actaeon7777/multifloor-amr/src/amr_system/amr_stack/maps/G_5_floor/MAP_SOURCE.md

# 5층 지도 (실측, 4층 좌표계 정렬)

- `5_floor_1006_slam.*`: 2026-10-06 5층 SLAM 원본 (받은 그대로, 자체 좌표계)
- `5_floor_1006.*`: 원본을 4층 지도 좌표계로 옮긴 실차용 지도 (`floors.yaml`의 `map`)
  - 변환(원본 → 4층): yaw 182.844°, t (46.294, 0.562) m. 셀 격자는 4층과 같고 범위만 넓다.
  - 원본 벽의 59%가 4층 벽 0.15 m 이내, 엘리베이터 문 위치 차이 약 4.5 cm.
  - 층을 바꿀 때 자세 값을 그대로 쓰므로(엘리베이터 미션 RELOCALIZE) 모든 층이 같은 좌표계여야 한다.
  - 다시 만들기: `scripts/align_floor_map.py 5_floor_1006_slam.yaml ../G_4_floor/4_floor_0522.yaml 5_floor_1006.yaml`
- `5_floor_tmp_from_4F(영역지정).png`: 시뮬레이션 전용. 내용은 아직 4층 영역지정의 복사본이며 새 지도 격자에 맞춰
  바깥만 넓혔다. 시뮬레이션 5층 장면(`sim_map`, `sim_layer`)도 아직 4층 복사본이다.
- 호실 좌표(`floors.yaml` rooms)는 4층 값을 옮긴 것이다. 새 지도에서 모두 복도 빈 공간이지만 실제 문 위치는 현장 확인 전이다.
