actaeon7777/multifloor-amr/src/amr_system/amr_web_ui/README.md

# AMR Web UI

컨셉 A Clarity 운영 웹과 로컬 HTTP / ROS 브리지다.

- [차량 스택과 웹 실행](../../../docs/README.md#1-amr-실행)
- [웹 접속](../../../docs/README.md#2-웹-접속)
- [주행 조작](../../../docs/README.md#3-주행-조작)
