actaeon7777/multifloor-amr/PORTING_JAZZY.md

# Jazzy 포팅 기록

차량 운용은 [실운용 실행법](docs/README.md)을 사용한다.
기존 포팅 기록은 [이력](docs/archive/20261007/root/PORTING_JAZZY.md)에 보관한다.
