actaeon7777/multifloor-amr/실행법.md

# AMR 실행법

차량 실행부터 종료까지는 **[실운용 실행법](docs/README.md)**을 사용한다.
