actaeon7777/multifloor-amr/docs/KIOSK.md

# 배송 키오스크

Jetson의 가로 터치 화면에서 사용하는 배송 화면이다. 웹 주소는
`http://127.0.0.1:8080/kiosk`이며, 1920×1280 화면을 Chromium 배율 1.5
(CSS 1280×853)로 표시한다. 서버가 준비되어 있어야 한다.

## 시작·종료

로그인한 데스크톱의 터미널에서 `scripts/kiosk/launch.sh`를 실행한다.
`AMR_WEB_PORT=8080`으로 포트를 지정할 수 있다. 실행기는 웹 응답을 최대 약 2분 기다린 뒤
별도 Chromium 프로필 `~/snap/chromium/common/amr-kiosk`로 연다.
`curl`, `flock`, `gsettings`, `xwininfo`·`xprop`(x11-utils), Python 3, libX11, Snap Chromium이 필요하다.
Chromium 자체의 `--kiosk` 전체화면은 약 0.1초 뒤 일반 창으로 풀리므로(2026-10-28 측정), 실행기가
브라우저가 떠 있는 동안 창 상태(`_NET_WM_STATE_FULLSCREEN`)를 처음 30초는 0.5초, 이후 2초 간격으로 확인해 풀리면 다시 요청한다.

종료는 관리 모드의 **키오스크 닫기**(화면만 닫고 로봇은 계속 켜져 있음), 키보드 `Alt+F4`, 또는 실행한 터미널에서 `Ctrl+C`.
**키오스크 닫기**는 서버가 실행기 PID 파일(`$XDG_RUNTIME_DIR/amr-kiosk-<UID>.pid`)의 `launch.sh`에 SIGTERM을 보내는 방식이라
실행기가 없으면 `--class=amr-kiosk` Chromium을 직접 닫는다. 로봇 PC 자신(loopback)에서 보낸 요청만 받고, PIN이 있으면 관리 모드 토큰이 필요하다.
바탕화면 "AMR 시작" 아이콘은 키오스크를 사용자 서비스 `amr-kiosk`(systemd-run)로 띄운다. 바탕화면 아이콘(DING)에서 바로 실행한 프로세스는
AppArmor 라벨 `desktop-icons-ng`를 물려받는데 Chromium snap이 이 라벨이 보내는 종료 신호를 거부해서, 실행기가 브라우저를 닫지 못하고 멈췄기 때문이다(2026-10-28 확인).
"AMR 종료"는 `systemctl --user stop amr-kiosk`로 닫는다.
실행기를 새로 띄울 때 실행기 없이 남은 키오스크 Chromium이 있으면 먼저 닫는다(남아 있으면 새 실행이 기존 창에 주소만 넘기고 끝나 전체화면 감시·키오스크 닫기가 동작하지 않는다).
실행 중 화면 꺼짐·잠금을 해제하고 정상 종료·종료 신호 처리 때 이전 값을 복원한다.
강제 종료(SIGKILL)·전원 차단은 복원을 실행할 수 없으므로 GNOME 설정을 확인한다.
브라우저 종료는 배송 취소가 아니다. 배송 취소에는 화면의 **정지**를 누른다.

자동 시작은 필요할 때 사용자가 설치한다. 이 작업에서는 설치하지 않는다.

```bash
mkdir -p ~/.config/autostart
cp /home/acus03/amr_ws/scripts/kiosk/amr-kiosk.desktop ~/.config/autostart/
```

다른 checkout에서는 desktop 파일의 `Exec` 절대 경로를 바꾼다.
자동 시작 해제는 `~/.config/autostart/amr-kiosk.desktop`을 삭제한다.

## 화면·배송

- **대기**: 층과 호실 선택 → 배송지 확인 → 출발. 현재 층은 `현재 층`, 비활성 층은 `운행 안 함`으로 표시한다.
- **배송 중**: 출발 버튼을 누르면 즉시 표시하고 약 3초 후 목표를 한 번 전송한다. 대기 중에는 진행률 0, 예상 도착 미표시이며 카운트다운은 없다. 이때 정지는 전송 없이 대기만 취소한다. 전송 후 정지는 진행 중인 배송을 보낸 곳과 관계없이 취소한다(브라우저가 다시 떠도 정지할 수 있게).
- **엘리베이터**: 승강장 이동·호출·탑승·층 이동·하차·호실 도착의 6단계와 경과 시간을 표시한다.
- **도착 / 배송 실패 / 배송 취소**: 이 키오스크가 보낸 호실 배송의 결과. `수령 확인` 또는 `확인`을 누르고 서버가 승인할 때까지 유지한다. 같은 탭 새로고침에도 배송 요청 ID를 기억한다.
- **준비 중**: 위치·층·주행 준비 확인 전에는 호실 선택이 잠긴다.
- **수동 조작 / 비상 정지**: 배송 화면보다 우선 표시한다.
- **연결 대기**: 조회 실패 또는 약 3초 이상 된 상태에서는 마지막 화면 위에 표시하고 새 명령을 막는다. 미전송 출발 대기는 취소하며 자동 재출발하지 않는다.

진행률은 유효한 거리 피드백을 받은 첫 3초의 최대 남은 거리 대비 감소량이며 뒤로 줄지 않는다. 초기 0.05 m 이하 값은 무시한다. 예상 도착은 최근 약 10초의
거리 감소 속도로 추정하며 데이터가 부족하면 0.3 m/s를 사용한다. 배터리는 신선한 BMS 잔량을 우선 사용하고, 없으면 기존 대시보드의 전압 기준으로
추정한다. 유효한 전원 데이터가 없으면 숨긴다. 지도·호실 좌표와 다른 층의 지도 버전은 `/api/floors`에서 가져온다. 현재 층 명령에는 `/api/kiosk/state`의 라이브 지도 버전을 사용한다.

## 관리 모드

상단 ⚙를 누른다. PIN은 웹 UI를 띄우는 터미널에서 `export AMR_KIOSK_PIN=<숫자>`로 설정한다.
`kiosk_pin:=` launch 인자도 받지만 명령줄(`ps`)에 PIN이 그대로 보이므로 쓰지 않는다. PIN이 있으면 숫자 키패드로 잠금을 해제한다. 미설정 시 바로 열리고
`PIN 잠금 해제됨 (시험 운영)`을 표시한다.

현재 층 지도에서 위치를 누르고 방향으로 끈 뒤 `적용`을 누른다. `마지막 위치로 시작`에는
현재 층 이름·저장 시각이 표시되며 해당 `적용`으로 현재 지도의 저장 위치를 전송한다. `현재 층 변경`은 실제 층 정보가 다를 때 사용한다.
주행·요청 처리 중에는 위치·층 변경 버튼이 잠긴다.

토큰은 메모리에만 보관한다. `관리 모드 종료`, 5분 입력 없음, 토큰 유효기간 만료 또는
관리 요청의 403 오류에서 관리 모드를 종료한다. 서버 오류는 화면에 그대로 표시한다.

## 원격 정지(관리자 정지)

중앙 관제의 **정지**는 로봇 내부에 관리자 정지를 설정하고 진행 중 목표를 취소한다.
연결이 끊겨도 유지되며, **해제**는 정지만 풀고 이전 배송을 재개하지 않는다. 조이스틱 LB 수동 조작은 계속 가능하다.
키오스크는 `관리자 정지 중`을 표시하며 관리 모드에 들어갈 수 있다. 엘리베이터 구간에서 누른 정지는
하차가 끝날 때까지 보류되고 층간 이동 화면에 `하차 후 정지 예정`이 뜬다([실차 레퍼런스](REAL_VEHICLE.md#원격-정지관리자-정지)).

**복귀**는 정지를 해제하고 기존 목표 종료·주행 준비를 기다린 뒤 `floors.yaml`의
`home`(초기값 4F 401호)으로 이동한다. 30초 안에 출발할 수 없으면 실패 사유를 표시한다.
복귀 화면은 `관리자 호출로 복귀 중`이며 배송 정지 버튼·수령 확인·배송 알림을 표시하지 않는다.
`/api/state`와 `/api/kiosk/state`의 `hold`, 서버에서 계산한 `task`, `goal.origin`으로 상태를 구분한다.
`/api/stop`, `/api/resume`, `/api/return_home`은 운영자용이며 키오스크 헤더로 요청하면 403이다.

## 야간 순찰

중앙 관제 또는 로봇 터치 패널의 **관리 모드 → 야간 순찰**에서 등록 경로를 선택해 **순찰 시작**을 요청한다. 키오스크는 수신 후 3초 미만인
`patrol.active=true` 상태에서 **야간 순찰 중** 경고 화면과 `경로 · 순서/전체 · 이동/관측/복귀`를
표시하고 배송지 선택을 막는다. 비상 정지·수동 조작·관리자 정지가 순찰 화면보다 우선한다.
상단 관리 모드에는 계속 들어갈 수 있다. 3초 이상 오래된 순찰 상태는 화면을 잠그지 않으며,
종료(`DONE`)·중단(`ABORTED`) 후 `active=false`이면 기존 배송·준비 상태에 따른 화면으로 돌아간다.

로컬 `/api/patrol/start`는 `{request_id, route}`, `/api/patrol/stop`은 `{request_id}`를 받는
운영자 및 키오스크 관리 모드용 POST다. PIN이 설정되어 있으면 키오스크 요청에는 유효한 관리자 토큰이 필요하며,
없으면 403 `관리 모드 잠금을 먼저 해제하세요.`로 거절된다. PIN 미설정 시 토큰 없이 허용한다. 시작은 등록된 경로와
주행 준비가 필요하며 진행 중 목표·층간 미션·관리자 정지 시 409다. 순찰 중 새 배송은
`야간 순찰 중에는 배송을 받을 수 없습니다. 중앙 관제에서 순찰을 정지하세요.`로 거절된다.
순찰 정지는 신선한 활성 순찰이 있을 때만 받는다.

관리 모드의 야간 순찰 블록에는 경로 선택·진행 상태·**순찰 시작**·**순찰 정지**가 표시된다.
경로 목록이 바뀌어도 선택한 경로가 남아 있으면 선택을 유지한다. 시작 요청이 접수되면 관리 모드를
종료하고 순찰 상태 수신 후 **야간 순찰 중** 화면을 표시한다. 정지하려면 상단 ⚙로 관리 모드에
다시 들어간다. 주행 중에도 순찰 정지 버튼을 사용할 수 있으며, 서버가 거절하거나 응답이 지연되면
오류 문구를 화면에 표시한다. 오프라인·요청 처리 중에는 버튼이 잠기고, 관리자 정지·진행 중 목표·
관리 작업 차단 상태에서는 순찰 시작을 할 수 없다.

명령은 executor에서 `/patrol/command`에 발행하고 `/patrol/status`의 같은 요청 ID 응답을
기다린다. HTTP 202 이후 상태의 `notice`가 `SUCCEEDED` 또는 `FAILED`로 갱신되며,
3초 안에 응답이 없으면 `순찰 노드가 응답하지 않습니다.`가 표시된다. 자동 재전송은 없다.
preview는 ROS 송신 없이 순찰 상태를 바꾸고 `PREVIEW`로 완료한다.
기존 관리자 **정지**·**복귀**도 순찰 정지를 먼저 발행한 뒤 기존 동작을 수행한다.
