actaeon7777/multifloor-amr/reports/profile/20261025_144835_before_opt.csv

time | label | pid | cpu_percent | rss_mb | threads
0.1 | _total | 0 | 69.4 |  | 3.70
0.1 | snapd | 1083 | 0.0 | 40 | 13
0.1 | gnome-shell | 4572 | 0.0 | 470 | 19
0.1 | gnome-shell | 4611 | 0.0 | 16 | 7
0.1 | gnome-shell | 4633 | 0.0 | 25 | 10
0.1 | gnome-software | 4717 | 0.0 | 257 | 8
0.1 | gnome-shell | 5028 | 0.0 | 25 | 10
0.1 | gnome-shell | 5194 | 0.0 | 60 | 13
0.1 | update-manager | 7391 | 0.0 | 230 | 7
0.1 | chrome | 23459 | 0.0 | 240 | 10
0.1 | ros2_launch | 23638 | 0.0 | 41 | 3
0.1 | sllidar_node | 23707 | 0.0 | 40 | 17
0.1 | scan_body_filter | 23708 | 0.0 | 85 | 15
0.1 | robot_state_publisher | 23709 | 0.0 | 43 | 15
0.1 | orbbec_camera_node | 23710 | 0.0 | 136 | 46
0.1 | depth_persistence_filter | 23711 | 0.0 | 44 | 16
0.1 | joy_node | 23712 | 0.0 | 45 | 16
0.1 | joy_teleop | 23713 | 0.0 | 83 | 15
0.1 | control_mux | 23714 | 0.0 | 84 | 16
0.1 | time_health | 23715 | 0.0 | 86 | 16
0.1 | can_telemetry | 23719 | 0.0 | 90 | 16
0.1 | ekf_node | 23723 | 0.0 | 49 | 16
0.1 | cmd_vel_to_can | 23724 | 0.0 | 87 | 15
0.1 | map_server | 23727 | 0.0 | 53 | 15
0.1 | amcl | 23728 | 0.0 | 62 | 17
0.1 | lifecycle_manager | 23729 | 0.0 | 46 | 17
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
