actaeon7777/multifloor-amr/reports/profile/20261025_201213_after_opt.csv

time | label | pid | cpu_percent | rss_mb | threads
0.1 | _total | 0 | 64.7 |  | 5.24
0.1 | snapd | 1083 | 0.0 | 28 | 13
0.1 | gnome-shell | 4572 | 0.0 | 333 | 19
0.1 | gnome-shell | 4611 | 0.0 | 3 | 7
0.1 | gnome-shell | 4633 | 0.0 | 10 | 10
0.1 | gnome-software | 4717 | 0.0 | 47 | 8
0.1 | gnome-shell | 5028 | 0.0 | 11 | 10
0.1 | gnome-shell | 5194 | 0.0 | 22 | 13
0.1 | update-manager | 7391 | 0.0 | 93 | 7
0.1 | chrome | 86484 | 0.0 | 282 | 17
0.1 | ros2_launch | 86628 | 0.0 | 42 | 3
0.1 | sllidar_node | 86679 | 0.0 | 37 | 17
0.1 | scan_body_filter | 86680 | 0.0 | 83 | 15
0.1 | robot_state_publisher | 86681 | 0.0 | 40 | 15
0.1 | orbbec_camera_node | 86682 | 0.0 | 135 | 46
0.1 | depth_persistence_filter | 86683 | 0.0 | 43 | 16
0.1 | joy_node | 86684 | 0.0 | 42 | 16
0.1 | joy_teleop | 86686 | 0.0 | 80 | 15
0.1 | control_mux | 86690 | 0.0 | 81 | 16
0.1 | time_health | 86693 | 0.0 | 84 | 16
0.1 | can_telemetry | 86695 | 0.0 | 87 | 16
0.1 | ekf_node | 86699 | 0.0 | 46 | 16
0.1 | cmd_vel_to_can | 86700 | 0.0 | 84 | 15
0.1 | map_server | 86704 | 0.0 | 50 | 15
0.1 | amcl | 86711 | 0.0 | 58 | 17
0.1 | lifecycle_manager | 86716 | 0.0 | 43 | 16
0.1 | planner_server | 86721 | 0.0 | 44 | 15
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
