actaeon7777/multifloor-amr/reports/profile/20261027_153326_after_opt2.csv

time | label | pid | ppid | exe | cpu_percent | rss_mb | threads
0.1 | _total | 0 | 0 |  | 62.1 |  | 4.59
1.3 | _total | 0 | 0 |  | 49.5 |  | 4.30
1.3 | snapd | 1086 | 1 | snapd | 0.0 | 31 | 13
1.3 | gnome-shell | 6736 | 6434 | gnome-shell | 2.6 | 394 | 19
1.3 | gnome-shell | 6778 | 6434 | gnome-shell-calendar-server | 0.0 | 7 | 7
1.3 | gnome-shell | 6816 | 6434 | gjs | 0.0 | 17 | 10
1.3 | gnome-shell | 7126 | 6434 | gjs | 0.0 | 18 | 10
1.3 | gnome-shell | 7307 | 6736 | gjs | 0.0 | 32 | 13
1.3 | chrome | 63673 | 37877 | claude | 0.0 | 287 | 11
1.3 | ros2_launch | 77126 | 39867 | ros2 | 0.0 | 41 | 3
1.3 | sllidar_node | 77183 | 77126 | sllidar_node | 6.1 | 39 | 17
1.3 | scan_body_filter | 77184 | 77126 | scan_body_filter | 1.7 | 84 | 15
1.3 | robot_state_publisher | 77185 | 77126 | robot_state_publisher | 0.9 | 42 | 15
1.3 | orbbec_camera_node | 77186 | 77126 | orbbec_camera_node | 8.7 | 124 | 46
1.3 | depth_persistence_filter | 77187 | 77126 | depth_persistence_filter | 1.7 | 44 | 16
1.3 | joy_node | 77188 | 77126 | joy_node | 2.6 | 44 | 16
1.3 | joy_teleop | 77189 | 77126 | joy_teleop | 1.7 | 82 | 15
1.3 | control_mux | 77190 | 77126 | control_mux | 6.1 | 82 | 16
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
