actaeon7777/multifloor-amr/docs/archive/20261007/root/실행법.md

> **이력 문서** · 2026-10-07 정리 시점의 이전 안내입니다. 현재 실행은 [최신 운영 문서](../../../README.md), 검증은 [검증 문서](../../../VALIDATION.md)를 사용합니다.

# 2026-10-06 PC 작업물 직접 이식 이후 실행

현재 `/home/acus03/amr_ws`에 새 주행·위치추정·웹 기능을 반영했다. 기존 `amr` 별칭을 유지한다.
**현재 실행 순서는 [중앙 관제 실행 안내](../docs/AMR_REMOTE_REAL_DRIVE_TEST.md)를 따른다.**

- 터미널 1: `./scripts/experiment.sh real can_dry_run:=true`로 먼저 확인한다.
- 터미널 2: `amr` 후 `ros2 launch amr_web_ui web_ui.launch.py use_sim_time:=false host:=127.0.0.1 port:=8080`.
- 터미널 3: 기존 `remote_client`로 중앙 서버 `100.88.249.77:8081`에 연결한다.
- 초기 위치 검증 후 Nav2가 활성화된다. 아래 과거 안내의 별도 stack/localization/navigation을 중복 실행하지 않는다.
- 실송신은 dry-run 종료 후 `./scripts/experiment.sh real`로 시작한다. 실제 주행은 현장 확인 뒤 수행한다.
- 다른 노트북은 기존 Tailscale 중앙 웹 주소를 사용한다. 새 자동 위치 찾기를 쓰려면 중앙 서버 업데이트도 필요하다.

이하 내용은 과거 실행 기록 및 개별 기능 참고다. 최신 통합 실행은 위 링크가 기준이다.

---

# AMR 실행법

## 2026-10-04 PC 전달본 적용

`amr_jetson_orin_20261004.tar.gz`의 소스를 이 Jetson 작업공간에 적용했습니다.
기존 `amr` / `stack` 명령과 아래의 터미널별 실행 방법은 그대로 사용할 수 있습니다.
새 터미널에서 `amr`을 실행해 새 빌드 환경을 불러오세요.

차량·센서·EKF + 저장 지도·AMCL + 내비게이션을 한 번에 실행할 수도 있습니다.
이 명령은 아래의 터미널 1~3을 대신하므로 둘을 동시에 실행하지 않습니다.

```bash
cd /home/acus03/amr_ws
# 먼저 CAN 송신 없이 센서 및 전체 스택 확인
./scripts/experiment.sh real can_dry_run:=true
# 위 명령을 Ctrl+C로 종료한 뒤, 실차 운용 준비가 끝나면 실제 CAN 송신
./scripts/experiment.sh real
```

웹 UI는 별도 터미널에서 `amr` 후 `ros2 launch amr_web_ui web_ui.launch.py`로 실행합니다.
실물은 ROS 도메인 7, `use_sim_time=false`이며 Isaac Sim 설치는 필요하지 않습니다.
원본 README는 PC 시뮬레이션 안내이므로 Jetson 운용에는 이 문서를 사용합니다.
적용 전 소스와 빌드 결과는 `backups/before_jetson_port_20261004/`에 보관했습니다.
이번 이식 결과와 검증 로그는 `diagnostics/jetson_port_20261004/`에 있습니다.

# rosbag 수집 명령어
amr
AMR_EXPERIMENT_MODE=real ./scripts/record_trial.sh

```bash
# 터미널 1: 실제 차량·센서·EKF (기존 stack)
amr
stack

# 터미널 2: 기존 지도·AMCL
amr
ros2 launch amr_stack localization.launch.py

# 터미널 3: 목표점 주행·RViz
amr
ros2 launch amr_stack navigation.launch.py use_rviz:=true

# 터미널 3: 웹 서버 제어 방식
amr
ros2 launch amr_stack navigation.launch.py

# 터미널 4: 웹 서버 실행
amr
ros2 launch amr_web_ui web_ui.launch.py
```

작업공간: `/home/acus03/amr_ws` · ROS 2 Jazzy

각 터미널에서 먼저 `amr`을 실행합니다. `stack`은 `ros2 launch amr_stack bringup.launch.py`의 별칭입니다.
이미 실행 중인 `stack`은 유지하고 필요한 기능만 다른 터미널에 추가합니다.

| 하고 싶은 작업 | 사용할 구성 | 문서 위치 |
|---|---|---|
| 저장된 지도에서 목표점으로 주행 | stack + AMCL + navigation | 2번 |
| 웹 지도에서 터치로 목표점 지정 | 기존 주행 구성 + amr_web_ui | 2번의 웹 UI |
| 조이스틱 수동 주행 | stack | 3번 |
| 새 지도 만들기·저장 | stack + SLAM Toolbox | 4번 |
| 저장 지도에서 위치추정만 실행 | stack + AMCL | 5번 |
| LiDAR·차량 모델 표시 | lidar 런치 | 6번 |
| CAN 송신 없이 센서나 명령 확인 | stack 실행 옵션 변경 | 7번 |
| 1 m 직진·90° 회전·반복 회전 | stack + 해당 시험 스크립트 | 8번 |
| 위치·속도·모드·토픽 조회 | ROS 조회 명령 | 9번 |
| 코드 변경 후 빌드 | colcon | 10번 |
| 하드웨어 없이 자동 테스트 | 격리된 ROS 도메인의 테스트 | 12번 |

## 1. 공통 준비

### 터미널 환경

```bash
amr
```

`amr` 별칭이 없는 터미널에서는 다음을 실행합니다.

```bash
cd /home/acus03/amr_ws
source /opt/ros/jazzy/setup.bash
source scripts/env.sh
```

### 실제 CAN을 사용할 때

등록한 `can0.service`가 부팅 시 CAN 인터페이스를 설정합니다. 현재 상태를 조회합니다.

```bash
ip -details link show can0
systemctl status can0.service
```

설정이 필요하면 차량을 정지시키고 기존 `stack`을 종료한 상태에서 **500 kbit/s, 일반 CAN**으로 준비합니다.
이미 올바르게 설정되어 있다면 아래 명령을 반복할 필요는 없습니다.

```bash
sudo systemctl restart can0.service
```

### 함께 실행하는 프로그램

- `stack`은 조이스틱·mux·CAN 송수신·LiDAR·차량 TF·EKF를 포함합니다.
- `localization.launch.py`는 저장 지도와 AMCL을 실행합니다.
- `navigation.launch.py`는 Smac 2D·DWB·방향 정렬 보조·복구·목표 관리를 실행합니다.
- SLAM과 AMCL은 각각 `map → odom`을 발행하므로 **둘 중 하나만 실행**합니다.
- `stack`과 `lidar.launch.py`를 동시에 실행하면 LiDAR·차량 TF가 중복됩니다.
- navigation과 8번의 주행 시험 스크립트는 모두 `/cmd_vel_auto`를 사용하므로 **한 가지만 실행**합니다.

## 2. 저장 지도에서 목표점 주행 — 평소 사용하는 실행

### 터미널 1: 차량·센서·EKF

```bash
amr
stack
```

기본값은 실제 CAN 송신입니다. 이미 실행 중이면 그대로 둡니다.

### 터미널 2: 저장 지도·AMCL

```bash
amr
ros2 launch amr_stack localization.launch.py
```

기본 지도는 `/home/acus03/amr_ws/maps/G_4_floor/4_floor_0522.yaml`입니다.
다른 지도를 사용할 때는 위 명령 대신 지도 경로를 지정합니다.

```bash
amr
ros2 launch amr_stack localization.launch.py \
  map:=/home/acus03/amr_ws/maps/my_map/map.yaml
```

### 터미널 3: 내비게이션·RViz

```bash
amr
ros2 launch amr_stack navigation.launch.py use_rviz:=true
```

RViz 없이 내비게이션만 실행하려면 `use_rviz:=true`를 생략합니다.

초기 위치를 지정하지 않은 상태에서 Nav2를 시작하면 `map`과 차량 사이 TF를 최대 60초 기다립니다.
그 시간 안에 초기 위치가 설정되지 않으면 활성화가 실패할 수 있으며, 이후 초기 위치만 보내도 자동 복구되지 않습니다.
이때는 MANUAL·정지·목표 취소를 확인하고, 초기 위치와 지도·스캔 정합을 확인한 후 navigation만 재시작합니다.
주행 전에 `planner_server`, `controller_server`, `behavior_server`, `bt_navigator`가 모두 `active [3]`인지 확인합니다.
중앙 웹만 사용하는 시험은 **차량·AMCL·웹·중앙 연결 → 초기 위치 → navigation** 순서로 실행합니다.
명령은 [중앙 관제 실주행 테스트](../docs/AMR_REMOTE_REAL_DRIVE_TEST.md), 실제 실패 근거는
[2026-10-06 분석 보고서](../../../../diagnostics/navigation_2026-10-06_remote/REPORT.md)에 정리했습니다.

2026-10-02 bag 분석 후 기본 자율주행 상한은 **0.40 m/s, 0.60 rad/s**로 조정했습니다.
전역·지역 inflation은 1.60m, 방향 정렬 참조 거리는 1.00m입니다.
설정을 반영하려면 RB로 MANUAL 전환해 정지한 뒤 navigation 터미널만 Ctrl+C하고 다시 실행합니다.
재시험 시작 때는 2D Pose Estimate로 위치를 잡고 지도·스캔을 확인한 뒤 navigation을 재시작합니다.
이 순서로 이전 좌표에서 누적된 전역 장애물 셀을 초기화합니다.
첫 번째 분석은 [주행 분석 보고서](diagnostics/navigation_2026-10-02/REPORT.md),
두 번째 bag의 벽 접근과 DWB 가중치 조정은 [DWB 튜닝 보고서](diagnostics/navigation_2026-10-02_trial2/REPORT.md)에 있습니다.
제어기는 기존 **RotationShim + DWB**입니다. 벽 비용·경로 비용·불필요한 회전 비용을 조정했습니다.
세 번째 bag의 직진 흔들림과 코너 정체에 맞춰 경로 방향 투영 0.50m, 예측 1.5초,
지역 목표 방향 비용과 회전 탐색 범위를 조정했습니다.
특히 정지 후 작은 회전 명령에 gyro 회전이 부족해 머무는 구간을 확인했습니다.
분석과 분리 시험은 [직진·코너 튜닝 보고서](diagnostics/navigation_2026-10-02_trial3/REPORT.md)에 있습니다.
다음 실험은 `AMR_EXPERIMENT_MODE=real ./scripts/record_trial.sh dwb_tracking`으로 설정과 실행 파라미터를 함께 저장하세요.
상세 DWB 후보 점수(`/evaluation`)는 기본으로 끕니다. 필요한 짧은 진단에서는 별도 navigation YAML에
`FollowPath.publish_evaluation: true`를 설정해 재실행할 수 있습니다.

### 웹 UI: 지도 터치로 목표점 지정

처음 한 번 웹 패키지를 빌드합니다. 기존 주행 구성은 그대로 사용합니다.

```bash
cd /home/acus03/amr_ws
env -i HOME="$HOME" PATH=/usr/bin:/bin LANG=C.UTF-8 /bin/bash --noprofile --norc -c \
  'source /opt/ros/jazzy/setup.bash && colcon build --symlink-install --packages-select amr_web_ui'
```

터미널 1~3의 stack·localization·navigation이 실행 중인 상태에서 터미널 4를 추가합니다.

```bash
amr
ros2 launch amr_web_ui web_ui.launch.py
```

Jetson의 브라우저에서는 `http://localhost:8080`, 같은 LAN의 PC/태블릿에서는
`http://<Jetson IP>:8080`에 접속합니다. 브라우저에는 ROS나 rosbridge 설치가 필요 없습니다.
외부 PC에서 ROS 브리지를 실행할 수도 있으며, 이 경우 PC와 Jetson 모두 `ROS_DOMAIN_ID=7`로 설정하고
브라우저는 그 PC의 8080 포트에 접속합니다. 웹 서버는 개발용 LAN에서 사용합니다.

- **초기 위치**: 로봇 위치와 방향을 지도에 클릭·드래그합니다. `/initialpose`를 전송합니다.
  지도와 스캔이 맞는지 확인한 후 **목표 지정**을 사용합니다.
- **목표 지정**: 이동 가능한 지도 위치를 **한 번 터치하면 바로 목표를 전송**합니다.
  누른 채 드래그하면 도착 방향도 지정합니다. 단순 터치는 현재 로봇 위치에서 목표를 향하는 방향을 사용하며,
  오른쪽 도착 방향을 직접 수정하면 그 값을 사용합니다.
- **지도 이동**: 드래그로 이동합니다. 휠·두 손가락·+/− 버튼으로 확대하고, 전체 보기로 복귀합니다.
  두 손가락 확대는 목표를 전송하지 않습니다.
- **주행 목표 취소**: 이 웹에서 전송한 현재 목표만 취소합니다. 취소 완료 응답을 확인합니다.
  수동 주행 정지나 하드웨어 비상정지 버튼은 아닙니다.
- 지도·AMCL·스캔·전역/지역 경로·지역 costmap·footprint를 기본 표시하고 전역 costmap은 선택 표시합니다.
- 현재 시험 구성에서는 MANUAL에 목표가 보관되며 RB로 AUTO에 진입하면 주행합니다.
  웹은 기존 조이스틱·주행 허용 정책을 변경하지 않습니다.
- 재접속할 때 목표를 자동 재전송하지 않습니다. 같은 웹 서버가 실행 중이면 현재 목표 상태를 다시 표시합니다.

웹은 RViz의 `/goal_pose`와 같은 목표 관리기에 공개 Action `/navigate_to_pose`로 연결합니다.
Action 응답으로 목표 접수·실패·도착·취소를 확인하며 `/cmd_vel`에는 발행하지 않습니다.

#### 차량 연결 없이 UI 미리보기

다음 명령은 실제 저장 지도를 사용하며 **ROS 노드나 주행 명령을 실행하지 않습니다.**

```bash
cd /home/acus03/amr_ws
PYTHONPATH=src/amr_system/amr_web_ui python3 -m amr_web_ui.server \
  --preview-map maps/G_4_floor/4_floor_0522.yaml --host 127.0.0.1 --port 8080
```

`http://localhost:8080`에서 터치·드래그·확대·레이어 조작을 확인합니다. 화면에 미리보기 배지가 표시됩니다.
실제 연결과 미리보기 모두 실행한 터미널에서 Ctrl+C로 웹 서버를 종료합니다.
자세한 구성은 [웹 UI README](../src/amr_system/amr_web_ui/README.md)에 있습니다.

### RViz config만 따로 열기와 `map` TF 오류

사용할 파일은 `src/amr_system/amr_stack/rviz/navigation.rviz`입니다.
위 navigation 런치도 같은 설정을 자동으로 엽니다. 이미 navigation을 RViz 없이 실행 중이거나
AMCL 위치추정만 확인할 때는 별도 터미널에서 다음 명령으로 엽니다.

```bash
amr
rviz2 -d /home/acus03/amr_ws/src/amr_system/amr_stack/rviz/navigation.rviz
```

Fixed Frame `map`, 지도 `/map`(Transient Local), 스캔 `/scan`(Best Effort),
로봇 기준축 `base_footprint`, AMCL 추정 위치 `/amcl_pose`, 경로와 지역 costmap이 설정되어 있습니다.
기본 4층 지도 전체가 보이는 배율로 시작하므로 마우스 휠로 현재 위치 주변을 확대합니다.
주황 화살표는 AMCL 위치·방향, 주황 타원은 위치 불확실성입니다.

`Invalid frame ID "map" ... frame does not exist`는 RViz config가 만드는 프레임이 아니라
**AMCL의 `map → odom` TF가 아직 없다는 뜻**입니다. `stack`과 localization이 실행 중인지
확인한 뒤, 지도 위 실제 차량 위치에서 **2D Pose Estimate**를 누르고 방향을 드래그합니다.
초기 위치 입력 전에는 이 로그와 로봇·스캔 표시 오류가 나올 수 있습니다.
지도는 Fixed Frame과 같은 `map` 좌표이므로 초기 위치를 지정하는 데 사용할 수 있습니다.
초기 위치와 정상 스캔·오도메트리 TF를 받으면 AMCL이 변환을 발행합니다.

입력 후에도 로그가 계속되면 다음으로 확인합니다.

```bash
amr
ros2 lifecycle get /map_server
ros2 lifecycle get /amcl
ros2 topic echo /map --once --field header --qos-durability transient_local
ros2 topic echo /scan --once --field header --qos-reliability best_effort
ros2 run tf2_ros tf2_echo odom base_footprint
# 위 명령은 Ctrl+C로 종료한 뒤 다음 변환도 확인합니다.
ros2 run tf2_ros tf2_echo base_footprint laser
ros2 run tf2_ros tf2_echo map odom
```

두 lifecycle 노드는 `active`여야 합니다. `/map`과 `/scan`이 도착하고,
`odom → base_footprint → laser`가 연결되어야 초기 위치 입력 뒤 `map → odom`을 얻을 수 있습니다.
`map` Fixed Frame을 다른 값으로 바꾸거나 임의의 정적 `map → odom`을 추가하는 것으로
AMCL 위치추정을 대신하지 않습니다.

### RViz와 조이스틱 조작

1. RViz의 Fixed Frame은 `map`을 사용합니다.
2. **2D Pose Estimate**로 현재 차량 위치와 방향을 지정합니다. AMCL 초기 위치가 이미 지정되어 있으면 유지합니다.
3. **2D Goal Pose**로 목적지를 클릭하고 드래그해 도착 방향을 지정합니다.
4. MANUAL 상태에서는 목표를 보관합니다. **RB를 한 번 눌러 AUTO로 전환**하면 주행을 시작합니다.

| 조작·상황 | 동작 |
|---|---|
| RB를 다시 눌러 MANUAL 전환 | 정지하고 목표 보관 |
| 다시 RB로 AUTO 진입 | 현재 위치에서 재계획해 보관한 목표로 재개 |
| 일시정지 중 LB 수동 주행 | 수동 이동 가능, 재개 시 바뀐 위치 사용 |
| 새 목표 지정 | 이전 목표를 새 목표로 교체 |
| 아래 목표 취소 명령 | 실행·보관 목표 모두 삭제 |
| 조이스틱 연결 단절 | 정지·MANUAL 전환, 목표 보관 |
| 조이스틱 재연결 | RB를 놓았다 다시 눌러 AUTO 재진입 |
| 도착·최종 실패 | 목표 종료, 재주행하려면 새 목표 지정 |
| navigation 종료·재실행 | 이전 목표 자동 복원 없음 |

RB는 누르고 있는 동안만 허용하는 버튼이 아니라 **누를 때마다 모드가 바뀌는 토글**입니다.
기본 화면은 기존 Humble 환경에서 사용하던 경량 화면을 Jazzy에서도 유지합니다.
초기 위치 설정 중 발생하던 TF 교착 상태도 피하도록 `amr_rviz_plugins/SingleThreadedTF`를
기본 사용합니다. navigation launch가 설치된 플러그인 경로를 RViz에 자동 전달합니다.
변경 적용에는 터미널 3을 종료·재실행하면 됩니다. 기존 실행 명령은 동일하며,
저장한 사용자 RViz 설정에서도 `Transformation -> Current`의
`amr_rviz_plugins/SingleThreadedTF` 선택을 유지합니다.
목표를 보관하는 일시정지·재개에는 **RB**를 사용합니다. 실행·보관 목표를 완전히 삭제하려면:

```bash
ros2 service call /navigate_to_pose/_action/cancel_goal action_msgs/srv/CancelGoal "{}"
```

초기 위치를 다시 지정할 때도 먼저 RB로 MANUAL 전환해 정지한 뒤 **2D Pose Estimate**를 사용합니다.
지도와 스캔이 맞는지 확인한 후 RB로 재개합니다. 주행 중 초기 위치를 바꾸면 경로 좌표가 갑자기 바뀔 수 있습니다.

차량 둘레의 형광 초록 사각형은 **Robot Footprint**로, 차체 0.640×0.544m에 사방 0.02m 여유를 더한
충돌 검사 외곽입니다. 벽·장애물 주변의 색 띠는 **costmap inflation**으로 가까울수록 높은 비용을 뜻합니다.
1.60m inflation 전체가 통행 금지인 것은 아닙니다. 전역 계획은 반경 0.44m 원형 모델이므로
약 0.88m보다 좁은 통로는 계획할 수 없으며, 격자·센서 오차를 고려하면 추가 여유가 필요합니다.

차량 CAD 모델과 Global Costmap은 기본으로 꺼져 있습니다. 필요할 때 Displays에서 켤 수 있습니다.
초록 footprint와 LaserScan·경로·Local Costmap은 기본으로 표시합니다.

상태를 별도 터미널에서 조회하려면 다음을 실행합니다.

```bash
amr
ros2 topic echo /navigation/status --qos-durability transient_local
```

## 3. 조이스틱 수동 주행

```bash
amr
stack use_rviz:=true
```

RViz가 필요 없으면 `stack`만 실행합니다. 지도·AMCL·navigation은 수동 주행에 필수가 아닙니다.

| 입력 | 기능 |
|---|---|
| MANUAL에서 LB를 누른 상태로 스틱 조작 | 수동 주행 |
| LB 놓기 | 수동 정지 |
| 전후 스틱 `axes[1]` | 전진·후진 |
| 좌우 스틱 `axes[2]` | 좌회전·우회전 |
| RB | MANUAL ↔ AUTO 전환 |

AUTO에서 MANUAL로 돌아온 후에는 **LB를 놓았다 다시 눌러야** 수동 주행이 재개됩니다.
기본 요청 상한은 선속도 1.00 m/s, 각속도 0.80 rad/s이며, 바퀴 속도 제한에 따라 최종 명령은 줄어들 수 있습니다.

## 4. SLAM으로 새 지도 만들기·저장

AMCL과 navigation을 종료하고 시작합니다. 지도 작성 중에는 MANUAL에서 LB로 차량을 조작합니다.

### 터미널 1: 차량·센서·EKF·RViz

```bash
amr
stack use_rviz:=true
```

### 터미널 2: SLAM Toolbox

Jazzy SLAM Toolbox는 lifecycle 활성화가 필요합니다. AMR 런치는 공식 동기식
lifecycle 런치를 사용하며 기존 AMR 파라미터를 `config/slam.yaml`에서 적용합니다.

```bash
amr
ros2 launch amr_stack slam.launch.py
```

RViz의 Fixed Frame을 `map`으로 바꾸고 **Add → Map**에서 `/map`을 선택합니다.
Map의 Durability는 **Transient Local**로 설정합니다.

### 터미널 3: AMCL에서 사용할 지도 저장

SLAM이 실행 중일 때 저장합니다. 아래 예시는 `maps/my_map/map`을 저장 이름으로 사용합니다.
기존 지도를 보존하려면 새로운 폴더·저장 이름을 사용합니다.

```bash
amr
mkdir -p /home/acus03/amr_ws/maps/my_map
ros2 run nav2_map_server map_saver_cli \
  -f /home/acus03/amr_ws/maps/my_map/map
```

생성된 `map.yaml`과 지도 이미지 파일을 함께 보관합니다.
저장 후 SLAM을 Ctrl+C로 종료하고, 2번 또는 5번의 AMCL 명령에 `map:=.../map.yaml`을 지정합니다.

### 선택: SLAM 재개용 pose graph도 저장

AMCL용 지도 이미지와 별도로 SLAM 그래프를 저장할 때 사용합니다.
위에서 만든 폴더에 저장하며, SLAM 노드가 실행 중이어야 합니다.

```bash
amr
ros2 service call /slam_toolbox/serialize_map \
  slam_toolbox/srv/SerializePoseGraph \
  "{filename: '/home/acus03/amr_ws/maps/my_map/map'}"
```

## 5. 저장 지도·AMCL만 실행

`stack`이 실행 중인 상태에서 다른 터미널에 추가합니다. SLAM은 먼저 종료합니다.

```bash
amr
ros2 launch amr_stack localization.launch.py
```

내비게이션 없이 지도·현재 위치만 볼 때 RViz를 따로 실행할 수 있습니다.

```bash
amr
rviz2 -d /home/acus03/amr_ws/src/amr_system/amr_stack/rviz/navigation.rviz
```

지도·스캔·AMCL 표시와 Fixed Frame `map`이 이미 설정되어 있습니다.
**2D Pose Estimate**로 현재 위치와 방향을 입력합니다. 목표점 주행은 2번의 navigation 런치를 추가합니다.

## 6. LiDAR·차량 TF만 실행

기존 `stack`이 종료된 상태에서 사용합니다. 조이스틱·CAN·EKF는 실행하지 않습니다.

```bash
amr
ros2 launch amr_stack lidar.launch.py use_rviz:=true
```

LiDAR 드라이버가 이미 별도로 실행 중이고 차량 모델·TF만 추가하려면 다음을 사용합니다.

```bash
amr
ros2 launch amr_stack lidar.launch.py start_lidar:=false use_rviz:=true
```

이때 외부 LiDAR의 스캔 프레임은 `laser`여야 하며 차량 TF 발행자는 하나만 둡니다.

## 7. CAN 송신 없이 실행

### 실제 센서·CAN 수신·EKF를 보고 싶을 때

기존 `stack`을 종료한 뒤 다음 구성으로 다시 실행합니다.

```bash
amr
stack can_dry_run:=true start_joy:=false use_rviz:=true
```

CAN 송신은 미리보기로 바뀌지만 **실제 CAN 수신과 LiDAR는 계속 사용**합니다.
따라서 `can0`와 센서 연결은 필요합니다.

### CAN·LiDAR 없이 조이스틱 → mux 명령을 보고 싶을 때

```bash
amr
stack can_dry_run:=true start_can_telemetry:=false start_lidar:=false start_ekf:=false
```

다른 터미널에서 CAN 변환 미리보기를 봅니다.

```bash
amr
ros2 topic echo /cmd_vel_to_can/tx_preview
```

출력은 `DRY_RUN ...` 형식이며 실제 CAN 프레임은 송신하지 않습니다.
물리 조이스틱도 사용하지 않으려면 실행 명령에 `start_joy:=false`를 추가합니다.

### CAN 수신 노드만 별도 실행

기존 `stack`이나 다른 `can_telemetry`가 실행되지 않은 상태에서 사용합니다.

```bash
amr
ros2 run amr_can_bridge can_telemetry --ros-args --params-file \
  /home/acus03/amr_ws/install/amr_stack/share/amr_stack/config/can_telemetry.yaml
```

## 8. 기존 주행 시험 스크립트

**navigation을 종료하고 시험 스크립트를 하나만 실행**합니다.
1 m·90° 시험에는 실제 `stack`, 조이스틱, LiDAR, 휠 오도메트리, IMU 피드백이 필요합니다.

### 1 m 직진

터미널 1은 `amr` → `stack`, 터미널 2는 다음과 같습니다.

```bash
amr
python3 src/straight_1m_test.py \
  --output "diagnostics/straight_$(date +%Y%m%d_%H%M%S)"
```

MANUAL 상태에서 `ready_press_RB_once_to_start`가 나오면 RB를 눌러 시작합니다.
최대 명령은 0.10 m/s입니다. 도중에 RB로 MANUAL 전환하면 시험이 종료되며 보관·재개하지 않습니다.

### 왼쪽 90° 회전

```bash
amr
python3 src/rotation_90_test.py \
  --output "diagnostics/rotation_$(date +%Y%m%d_%H%M%S)"
```

MANUAL 상태에서 `ready_press_RB_once_to_start_left_turn`이 나오면 RB를 눌러 시작합니다.
최대 명령은 0.15 rad/s이며 IMU 적분 각도를 기준으로 정지합니다.

두 시험은 완료·중단 후 자동 종료합니다. 다시 시험할 때는 MANUAL로 전환하고 스크립트를 새로 실행합니다.
`--output` 폴더는 아직 없는 이름이어야 하며, 결과는 `result.json`과 `samples.jsonl`에 저장됩니다.

### 우회전 2초 ↔ 좌회전 2초 반복

```bash
amr
python3 src/auto_turn_test.py
```

AUTO에서 각속도 -0.20 ↔ +0.20 rad/s를 반복합니다. RB OFF로 멈추고 다시 AUTO에 들어가면 우회전부터 재시작합니다.
이 스크립트는 AUTO에서 실행하면 즉시 시작합니다. 명령만 볼 때는 7번의 CAN 미리보기 구성을 사용합니다.

## 9. 상태·위치·속도·센서 조회

각 터미널에서 `amr`을 먼저 실행합니다. 계속 출력하는 명령은 Ctrl+C로 끝내고 다음 명령을 실행합니다.

### 수동·자율 모드와 목표 상태

```bash
ros2 topic echo /control_mux/mode --qos-durability transient_local
ros2 topic echo /control_mux/status --qos-durability transient_local
ros2 topic echo /navigation/status --qos-durability transient_local
```

### 주요 토픽

| 토픽 | 내용 |
|---|---|
| `/joy` | 조이스틱 입력 |
| `/cmd_vel_manual` | 수동 속도 요청 |
| `/cmd_vel_navigation` | Nav2가 계산한 속도 |
| `/cmd_vel_auto` | 목표 관리 또는 시험 노드의 자율 속도 요청 |
| `/cmd_vel` | mux가 선택하고 바퀴 제한을 적용한 최종 속도 명령 |
| `/odometry/filtered` | EKF 상대 위치·방향 및 추정 선속도·각속도 |
| `/amcl_pose` | AMCL의 지도 기준 위치·방향 추정 |
| `/wheel/odometry` | 바퀴 피드백 기반 오도메트리 |
| `/imu/data_raw` | IMU 각속도·가속도 |
| `/scan` | LiDAR 스캔 |
| `/diagnostics` | CAN 수신·센서 상태 |
| `/plan` | Smac 전역 경로 |
| `/local_plan` | DWB 지역 궤적 |

```bash
# 최종 명령 / EKF 추정 속도
ros2 topic echo /cmd_vel
ros2 topic echo /odometry/filtered --field twist.twist

# 위치추정·원시 센서 메시지 한 번 보기
ros2 topic echo /odometry/filtered --once
ros2 topic echo /amcl_pose --once
ros2 topic echo /imu/data_raw --once --qos-reliability best_effort
ros2 topic echo /diagnostics --once

# 수신 주기
ros2 topic hz /scan
ros2 topic hz /wheel/odometry
ros2 topic hz /odometry/filtered

# 현재 TF 위치·방향
ros2 run tf2_ros tf2_echo map base_footprint
ros2 run tf2_ros tf2_echo odom base_footprint

# 실행 중인 노드·토픽·Nav2 활성 상태
ros2 node list
ros2 topic list
ros2 lifecycle get /amcl
ros2 lifecycle get /planner_server
ros2 lifecycle get /controller_server
```

현재 차량의 지도 기준 자세는 `map → base_footprint` TF, 현재 속도 입력은 `/odometry/filtered`를 사용합니다.
`/cmd_vel`은 측정 속도가 아니라 차량에 보내는 명령입니다.

## 10. 코드 변경 후 빌드

Jazzy 환경에서 병렬 작업 수를 2로 제한하여 빌드합니다.

```bash
cd /home/acus03/amr_ws
source /opt/ros/jazzy/setup.bash
MAKEFLAGS=-j2 CMAKE_BUILD_PARALLEL_LEVEL=2 colcon build --base-paths src --symlink-install \
  --parallel-workers 2 --cmake-args -DCMAKE_BUILD_TYPE=Release
```

빌드 후 실행할 터미널에서 `amr`을 다시 실행합니다. 변경된 노드·설정은 해당 런치를 재시작해 적용합니다.
이 빌드는 STM32 펌웨어를 업로드하지 않습니다.

## 11. 자주 쓰는 실행 옵션·설정 파일

### stack 옵션

| 옵션 | 기본값 | 역할 |
|---|---|---|
| `use_rviz` | `false` | LiDAR·차량 모델 RViz 실행 |
| `start_lidar` | `true` | LiDAR 드라이버 실행 |
| `start_joy` | `true` | 실제 조이스틱 드라이버 실행 |
| `start_can_bridge` | `true` | CAN 송신 브리지 실행 |
| `can_dry_run` | `false` | CAN 송신을 미리보기로 변경 |
| `start_can_telemetry` | `true` | 실제 CAN 피드백 수신 |
| `start_ekf` | `true` | EKF 실행 |

옵션은 `stack start_lidar:=false`처럼 뒤에 붙입니다.

### 지도·내비게이션 옵션

| 런치 | 옵션 | 역할 |
|---|---|---|
| localization | `map:=/절대경로/map.yaml` | 사용할 저장 지도 |
| localization | `localization_config:=/절대경로/config.yaml` | AMCL·map server 설정 |
| navigation | `use_rviz:=true` | 목표 주행용 RViz 실행 |
| navigation | `navigation_config:=/절대경로/config.yaml` | Nav2·목표 관리 설정 |
| navigation | `control_config:=/절대경로/config.yaml` | 바퀴 사양·속도 제한을 읽을 mux 설정 |

별도 `control_config`로 stack을 실행했다면 navigation에도 같은 파일을 지정합니다.
기본 설정은 `src/amr_system/amr_stack/config/` 아래에 있습니다.

| 파일 | 설정 대상 |
|---|---|
| `joy_teleop.yaml` | 조이스틱 매핑 |
| `control_mux.yaml` | 수동·자율 선택, 속도·바퀴 제한 |
| `can_bridge.yaml` | CAN 송신 |
| `can_telemetry.yaml` | CAN 피드백 수신 |
| `ekf.yaml` | EKF |
| `localization.yaml` | 저장 지도·AMCL |
| `navigation.yaml` | Smac·DWB·방향 정렬·costmap·복구·목표 관리 |

## 12. 하드웨어 없는 자동 테스트

`amr`로 환경을 불러온 뒤 작업공간에서 실행합니다. 각 명령은 테스트용 ROS 도메인을 지정합니다.
이 테스트들은 실제 차량·센서 드라이버를 실행하지 않으며, Nav2 통합 시험의 CAN은 dry-run입니다.

```bash
amr

# EKF
ROS_DOMAIN_ID=187 ROS_LOCALHOST_ONLY=1 AMR_RUN_EKF_TESTS=1 \
  python3 -m pytest -q src/amr_system/amr_stack/test/test_ekf_ros.py

# 저장 지도·AMCL
ROS_DOMAIN_ID=189 ROS_LOCALHOST_ONLY=1 AMR_RUN_LOCALIZATION_TESTS=1 \
  python3 -m pytest -q src/amr_system/amr_stack/test/test_localization_ros.py

# 목표 보관·재개·교체·취소
ROS_DOMAIN_ID=190 ROS_LOCALHOST_ONLY=1 AMR_RUN_NAVIGATION_TESTS=1 \
  python3 -m pytest -q src/amr_system/amr_stack/test/test_navigation_manager_ros.py

# Smac → DWB → 목표 관리 → mux → CAN dry-run
ROS_DOMAIN_ID=191 ROS_LOCALHOST_ONLY=1 AMR_RUN_NAV2_INTEGRATION=1 \
  python3 -m pytest -q src/amr_system/amr_stack/test/test_navigation_pipeline_ros.py

# DWB 바퀴 속도 제한 플러그인
ROS_DOMAIN_ID=192 ROS_LOCALHOST_ONLY=1 \
  colcon test --packages-select amr_nav2_plugins --return-code-on-test-failure
```

## 13. 종료·재실행

목표 주행을 끝낼 때는 위 목표 취소 명령을 사용하거나 RB로 MANUAL 전환해 정지합니다.
전체를 종료할 때는 **navigation → localization 또는 SLAM → stack** 순서로 각 터미널에서 Ctrl+C를 누릅니다.

- 지도 작성 후에는 SLAM 종료 전에 지도를 저장합니다.
- localization을 재시작하면 2D Pose Estimate로 초기 위치를 다시 지정합니다.
- navigation을 재시작하면 주행 목표를 새로 지정합니다.
- 기본 경량 화면은 충돌이 재현된 Nav2 RViz 플러그인을 불러오지 않습니다. 목표 지정은 **2D Goal Pose**입니다.
- RViz가 비정상 종료하면 navigation도 종료합니다. RB로 정지한 뒤 navigation을 다시 실행하고 새 목표를 지정합니다.

알고리즘·설정 설명은 [README](README.md), 구현과 시험 결과는
[내비게이션 구현 결과](diagnostics/navigation_2026-09-29/IMPLEMENTATION.md)에 있습니다.
