actaeon7777/multifloor-amr/docs/archive/README.md

# 문서 이력

이 폴더의 문서는 이전 실행법·포팅·설계·시험 기록입니다.
현재 운영 기준은 [docs/README.md](../README.md), 검증 기준과 결과는 [docs/VALIDATION.md](../VALIDATION.md)입니다.

2026-10-07 정리 때 기존 안내를 아래 경로로 보존했습니다. 날짜는 정리 시점이며 각 문서의 검증 시점은 본문을 따릅니다.
문서의 과거 주장과 명령은 유지했고, 이동에 필요한 상대 링크와 이력 표시만 정리했습니다.
원문 바이트 사본은 `backups/before_docs_unification_20261007_144528`에 있으며, [manifest](20261007/manifest.json)에 원문·보존본 체크섬을 기록했습니다.

| 이전 위치 | 보존 문서 |
|---|---|
| `docs/WORKSPACE_PORTABILITY.md` | [WORKSPACE_PORTABILITY.md](20261007/docs/WORKSPACE_PORTABILITY.md) |
| `docs/SIM2REAL.md` | [SIM2REAL.md](20261007/docs/SIM2REAL.md) |
| `docs/REAL_AMR_BASELINE.md` | [REAL_AMR_BASELINE.md](20261007/docs/REAL_AMR_BASELINE.md) |
| `docs/AMR_REMOTE_REAL_DRIVE_TEST.md` | [AMR_REMOTE_REAL_DRIVE_TEST.md](20261007/docs/AMR_REMOTE_REAL_DRIVE_TEST.md) |
| `docs/HOST_CONTROL_AGENT_PROMPT.md` | [HOST_CONTROL_AGENT_PROMPT.md](20261007/docs/HOST_CONTROL_AGENT_PROMPT.md) |
| `docs/AMR_REMOTE_COMM_TEST.md` | [AMR_REMOTE_COMM_TEST.md](20261007/docs/AMR_REMOTE_COMM_TEST.md) |
| `docs/ROLLBACK_PC_UPDATE_20261006.md` | [ROLLBACK_PC_UPDATE_20261006.md](20261007/docs/ROLLBACK_PC_UPDATE_20261006.md) |
| `README.md` | [README.md](20261007/root/README.md) |
| `실행법.md` | [실행법.md](20261007/root/실행법.md) |
| `PORTING_JAZZY.md` | [PORTING_JAZZY.md](20261007/root/PORTING_JAZZY.md) |
| `AMR_실물_이전_실행방법_20261006.txt` | [AMR_실물_이전_실행방법_20261006.txt](20261007/root/AMR_실물_이전_실행방법_20261006.txt) |
| `Control_Server/README.md` | [README.md](20261007/Control_Server/README.md) |
| `Control_Server/BUILD_WORKFLOW.md` | [BUILD_WORKFLOW.md](20261007/Control_Server/BUILD_WORKFLOW.md) |
| `Control_Server/HOST_CONTROL_AGENT_PROMPT.md` | [HOST_CONTROL_AGENT_PROMPT.md](20261007/Control_Server/HOST_CONTROL_AGENT_PROMPT.md) |
| `Control_Server/UPDATE_20261006.md` | [UPDATE_20261006.md](20261007/Control_Server/UPDATE_20261006.md) |
| `src/amr_system/amr_web_ui/README.md` | [README.md](20261007/src/amr_system/amr_web_ui/README.md) |
| `src/amr_system/amr_remote_bridge/README.md` | [README.md](20261007/src/amr_system/amr_remote_bridge/README.md) |
| `src/amr_system/amr_vehicle_status/README.md` | [README.md](20261007/src/amr_system/amr_vehicle_status/README.md) |
