actaeon7777/multifloor-amr/docs/images/Elevator_size.jpg

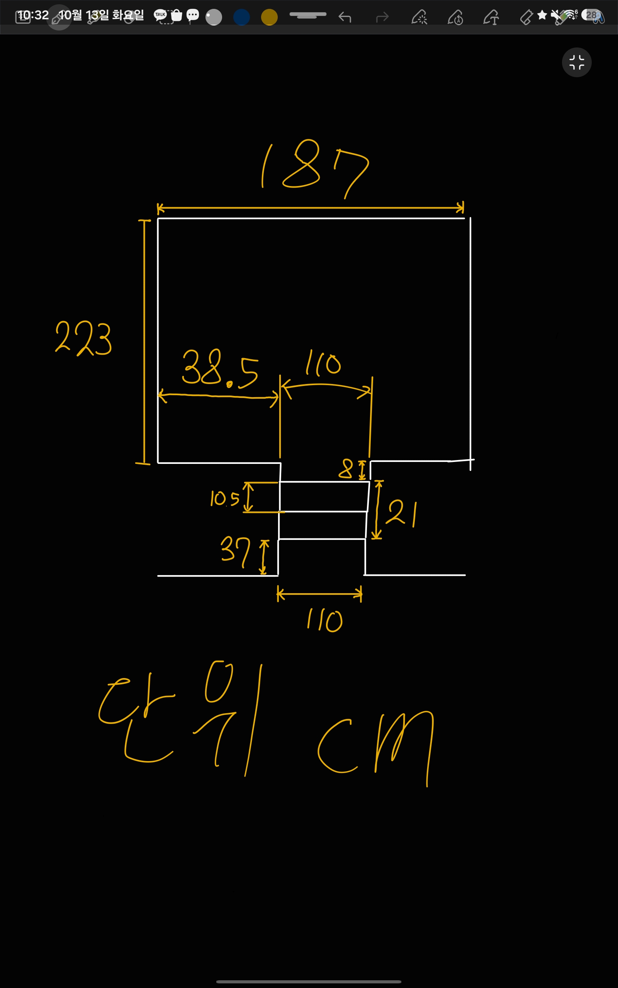
docs/images/Elevator_size.jpg
