actaeon7777/multifloor-amr/reports/patrol/patrol_4F_draft.png

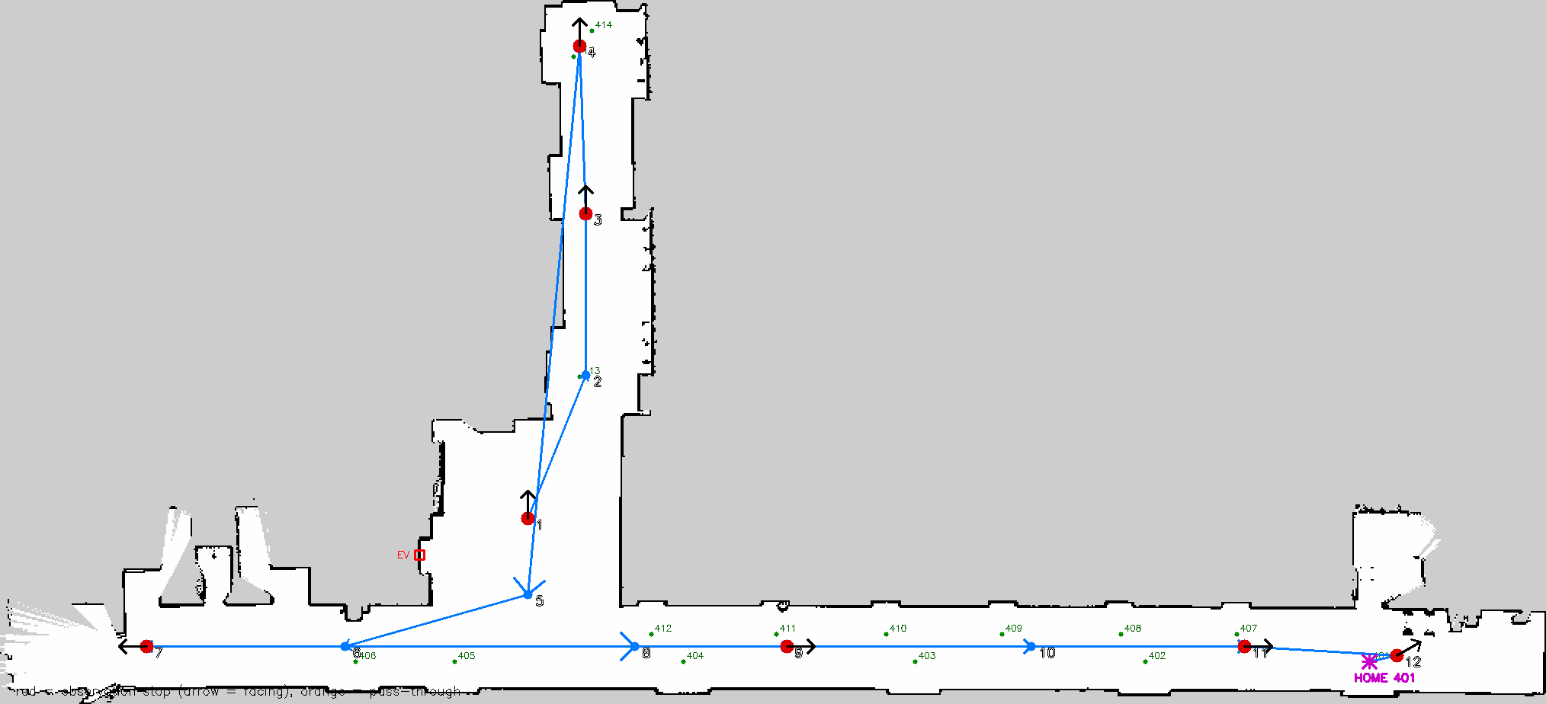
reports/patrol/patrol_4F_draft.png
