actaeon7777/multifloor-amr/src/amr_description/reports/v28_geometry_comparison.png

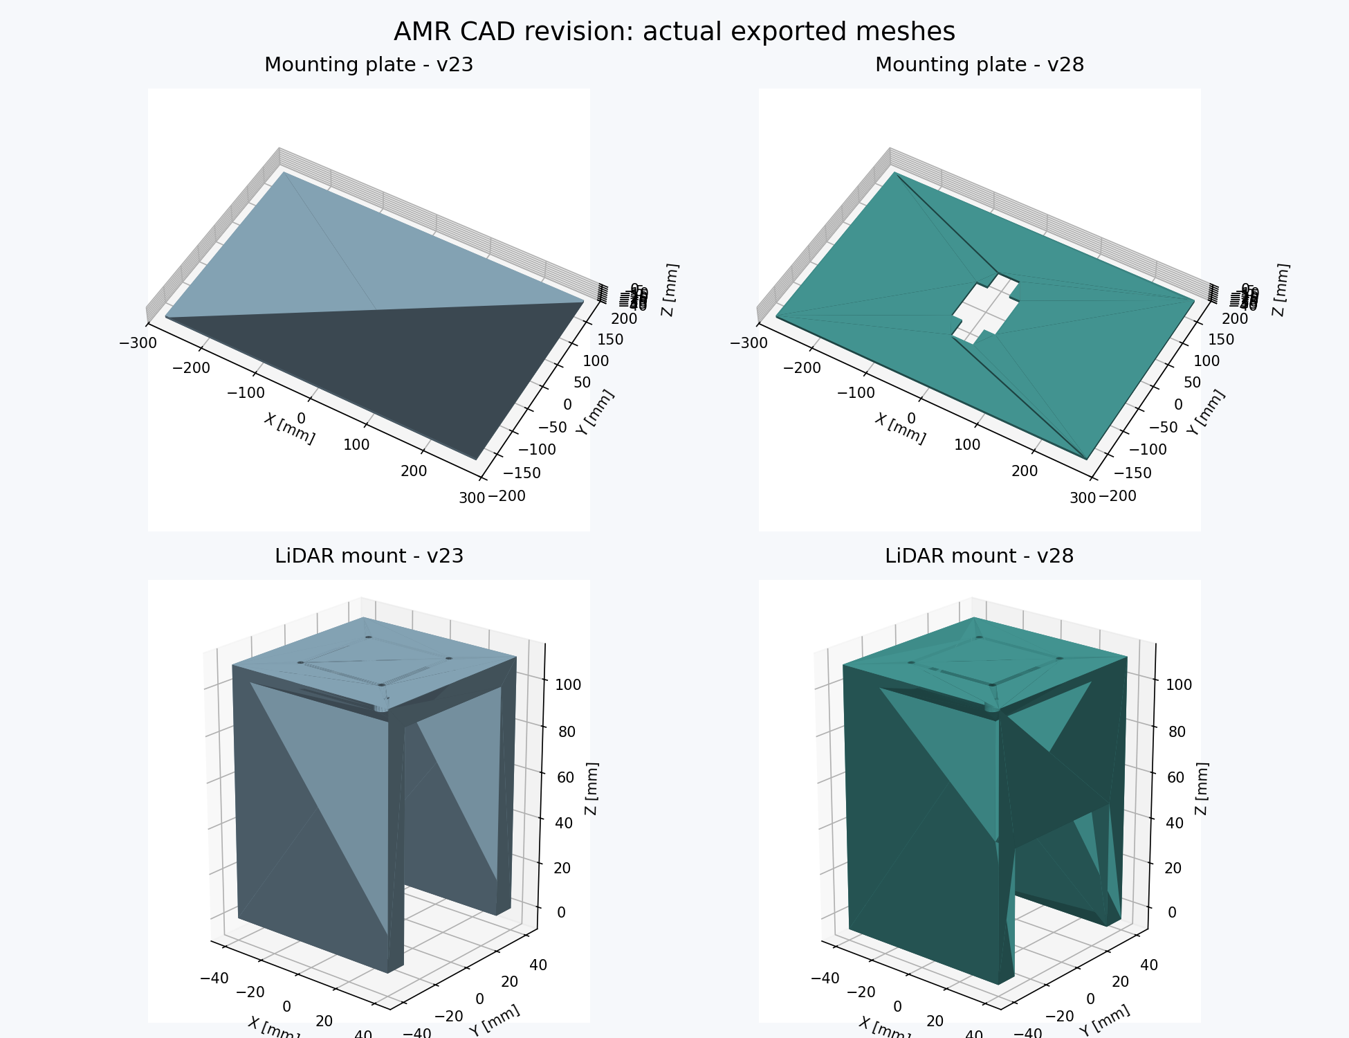
src/amr_description/reports/v28_geometry_comparison.png
