actaeon7777/multifloor-amr/src/amr_system/amr_stack/maps/G_4_floor/4_floor_0522(영역지정).png

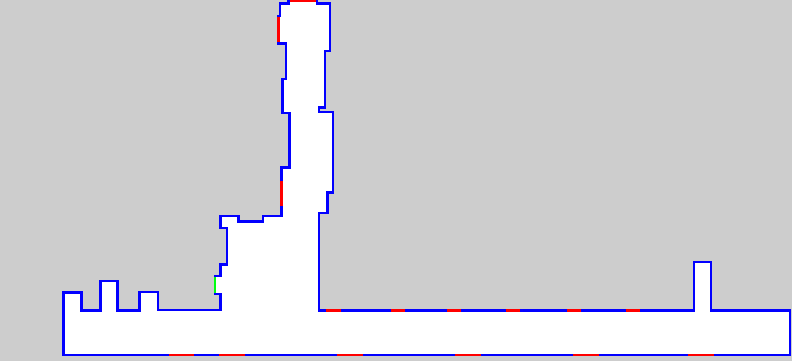
src/amr_system/amr_stack/maps/G_4_floor/4_floor_0522(영역지정).png
