actaeon7777/multifloor-amr/src/amr_description/meshes/reference/caster_assembly_reference.stl

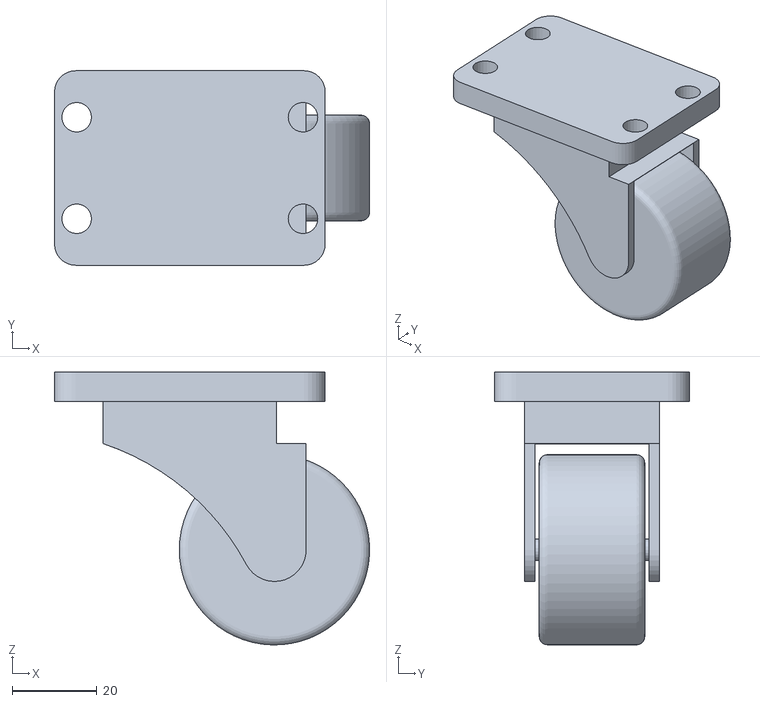
[picture p5: CAD file, 2026-10-15]
src/amr_description/meshes/reference/caster_assembly_reference.stl
74.5 x 46.0 x 64.5
