actaeon7777/multifloor-amr/src/amr_description/meshes/visual/chassis.stl

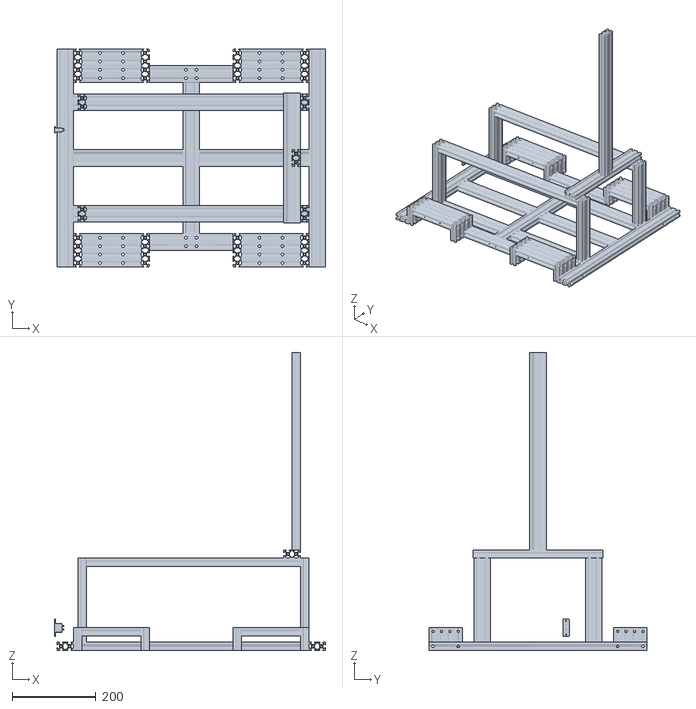
[picture p6: CAD file, 2026-10-20]
src/amr_description/meshes/visual/chassis.stl
646.0 x 520.0 x 710.0
