actaeon7777/multifloor-amr/src/amr_description/meshes/visual/gemini2.stl

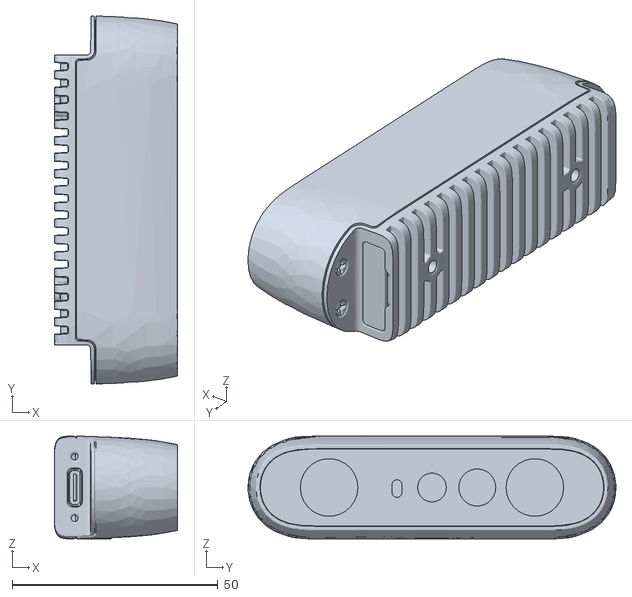
[picture p7: CAD file, 2026-10-20]
src/amr_description/meshes/visual/gemini2.stl
30.0 x 89.4 x 25.0
