actaeon7777/multifloor-amr/src/amr_description/meshes/visual/housing.stl

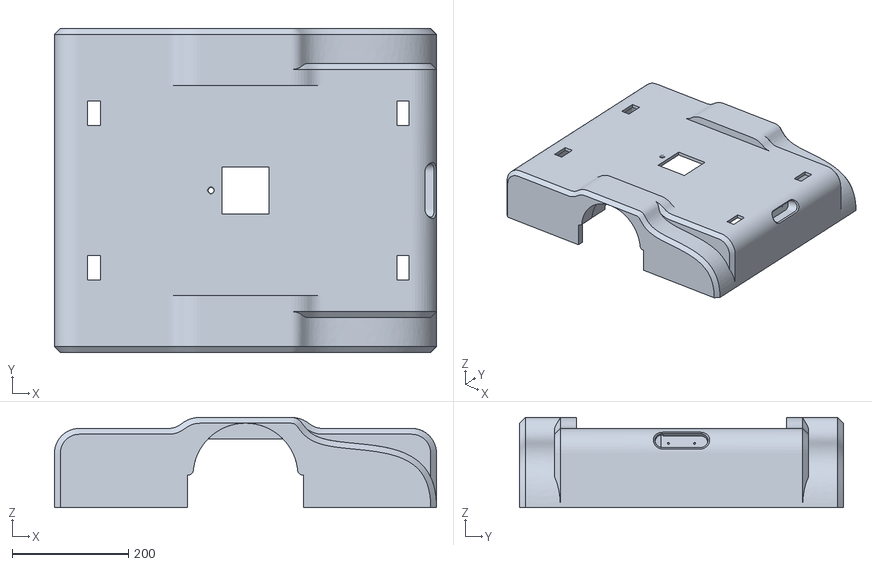
[picture p8: CAD file, 2026-10-20]
src/amr_description/meshes/visual/housing.stl
656.0 x 556.0 x 154.9
