actaeon7777/multifloor-amr/src/amr_description/meshes/visual/z10t.stl

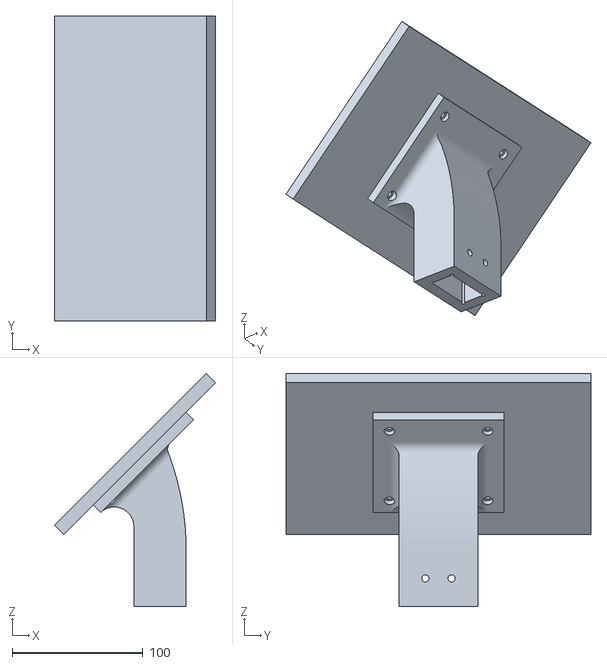
[picture p9: CAD file, 2026-10-16]
src/amr_description/meshes/visual/z10t.stl
123.0 x 233.0 x 178.0
