actaeon7777/multifloor-amr/src/amr_description/meshes/visual/drive_suspension.stl

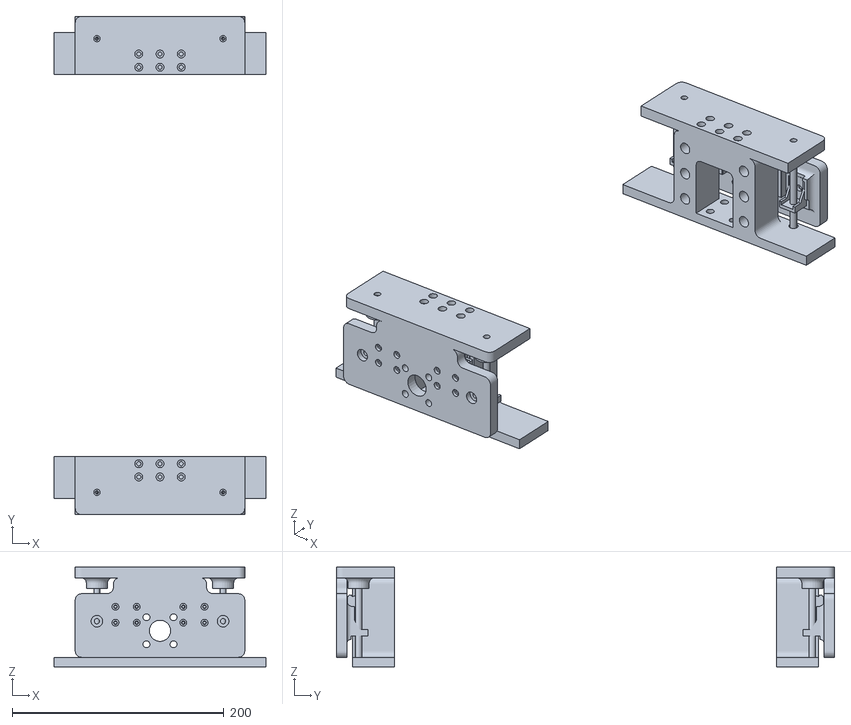
[picture p10: CAD file, 2026-10-16]
src/amr_description/meshes/visual/drive_suspension.stl
200.0 x 470.0 x 94.0
