actaeon7777/multifloor-amr/src/amr_description/meshes/visual/nurirobot_wa171_3d_v5.stl

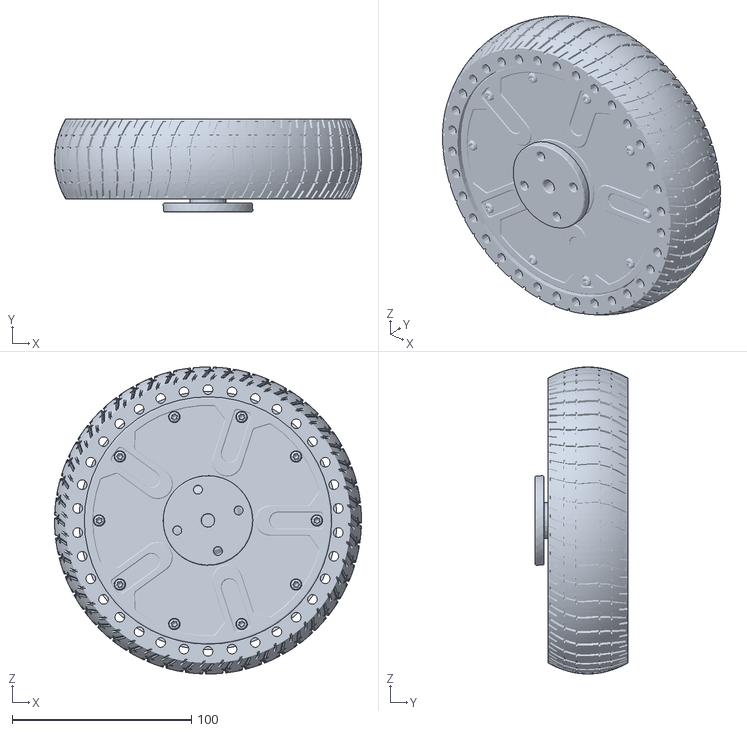
[picture p11: CAD file, 2026-10-15]
src/amr_description/meshes/visual/nurirobot_wa171_3d_v5.stl
171.3 x 51.8 x 171.3
