actaeon7777/multifloor-amr/src/amr_description/meshes/visual/caster_swivel_frame.stl

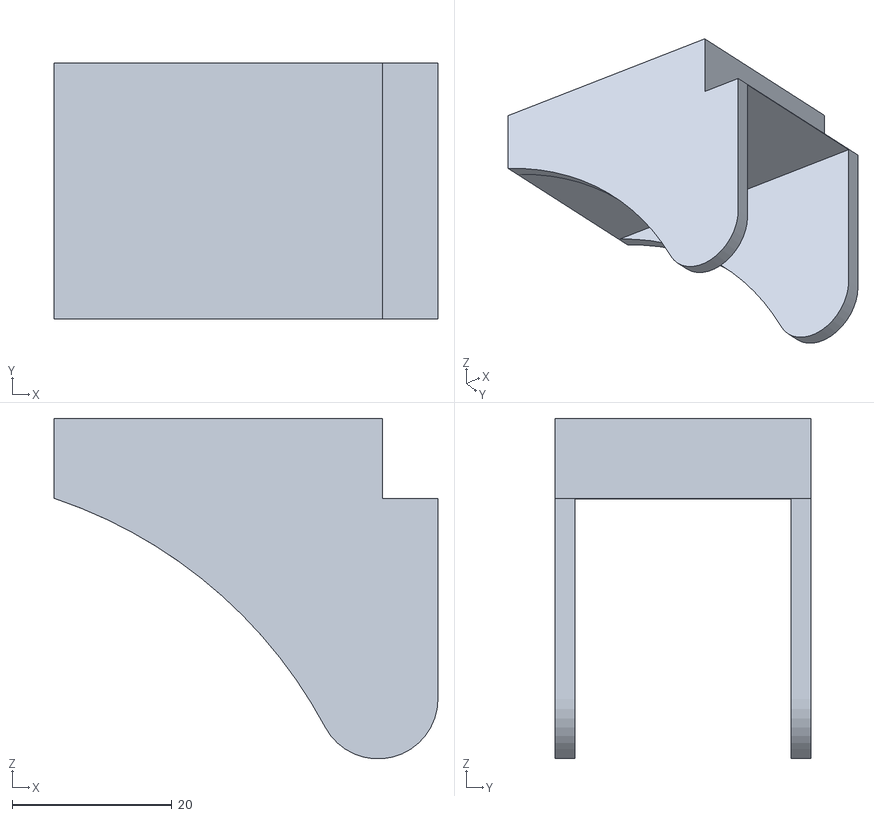
[picture p12: CAD file, 2026-10-15]
src/amr_description/meshes/visual/caster_swivel_frame.stl
48.0 x 32.0 x 42.6
