actaeon7777/multifloor-amr/src/amr_description/meshes/visual/caster_wheel.stl

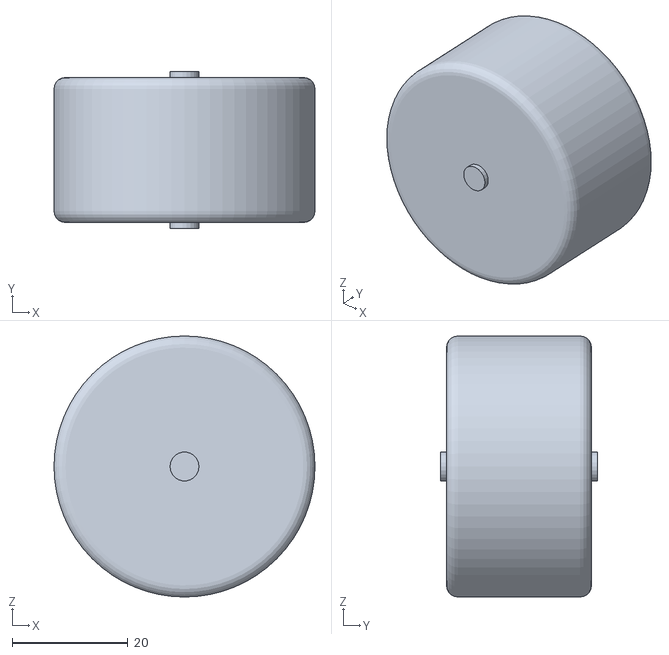
[picture p13: CAD file, 2026-10-15]
src/amr_description/meshes/visual/caster_wheel.stl
45.0 x 27.0 x 45.0
