actaeon7777/multifloor-amr/src/amr_description/meshes/visual/caster_mount_fixed.stl

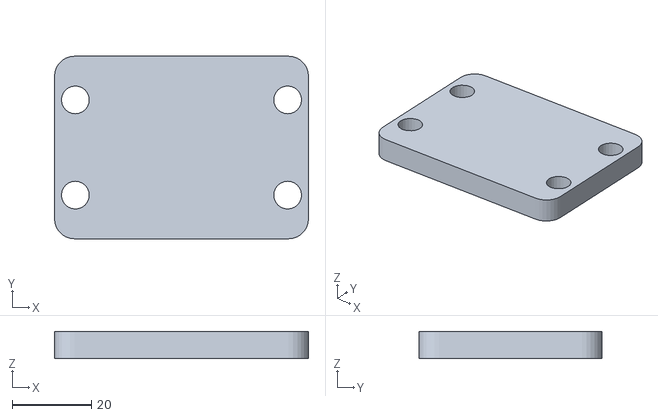
[picture p14: CAD file, 2026-10-15]
src/amr_description/meshes/visual/caster_mount_fixed.stl
64.0 x 46.0 x 6.90
