actaeon7777/multifloor-amr/src/amr_description/meshes/visual/lidar_mount.stl

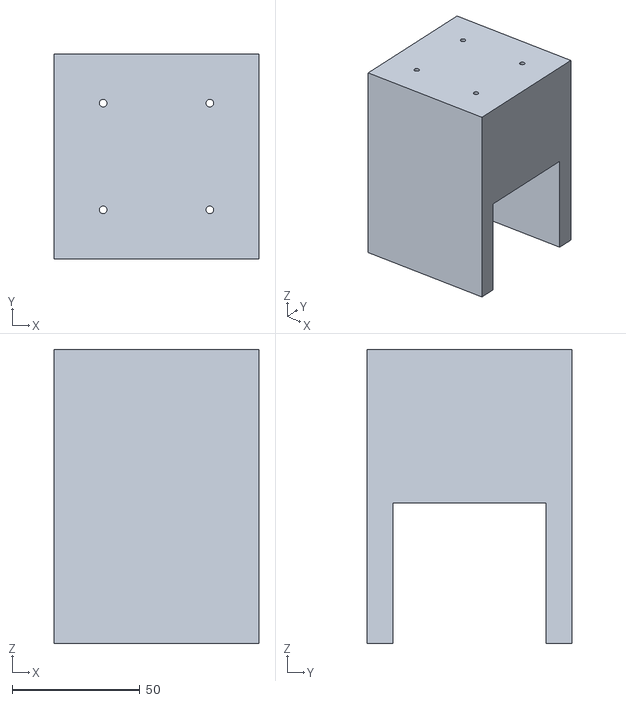
[picture p15: CAD file, 2026-10-15]
src/amr_description/meshes/visual/lidar_mount.stl
80.0 x 80.0 x 115.0
