actaeon7777/multifloor-amr/src/amr_description/meshes/visual/mounting_plate.stl

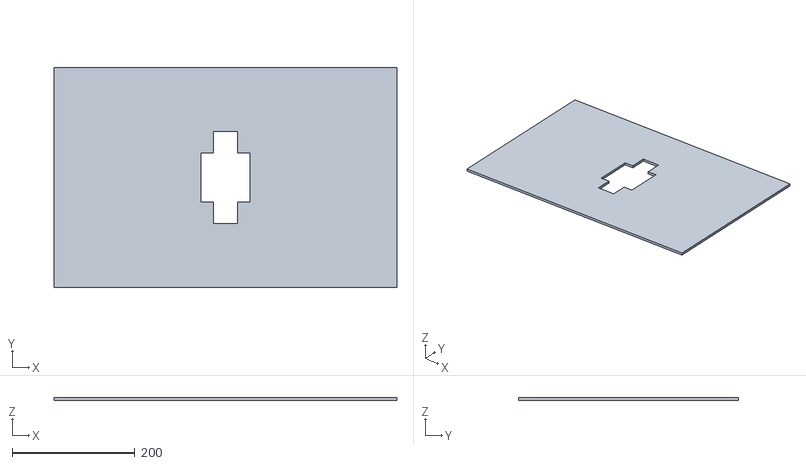
[picture p16: CAD file, 2026-10-15]
src/amr_description/meshes/visual/mounting_plate.stl
560.0 x 360.0 x 5.00
