actaeon7777/multifloor-amr/src/amr_description/meshes/visual/lidar_body.stl

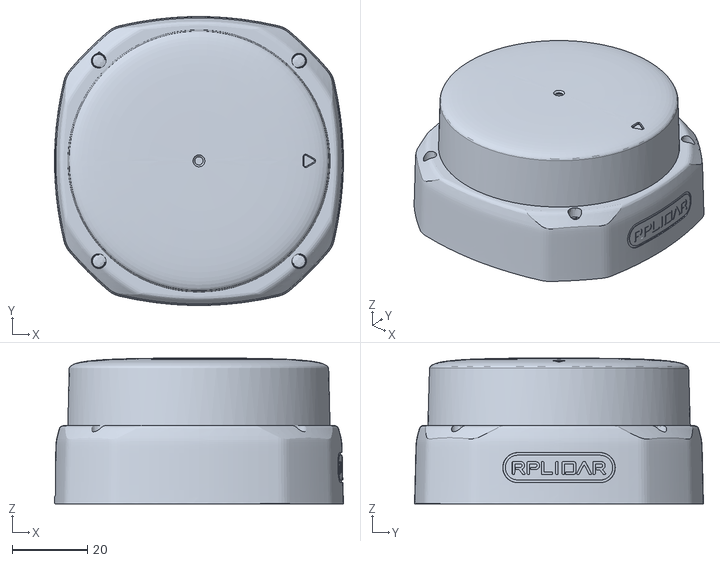
[picture p17: CAD file, 2026-10-15]
src/amr_description/meshes/visual/lidar_body.stl
77.0 x 77.0 x 38.9
