actaeon7777/multifloor-amr/(list of files, cad)

Other CAD files:
src/amr_description/meshes/reference/amr_master.stl
