actaeon7777/multifloor-amr/src/amr_description/urdf/capstone_amr.urdf

<?xml version="1.0" ?>
<!-- =================================================================================== -->
<!-- |    This document was autogenerated by xacro from amr_description/urdf/capstone_amr.urdf.xacro | -->
<!-- |    EDITING THIS FILE BY HAND IS NOT RECOMMENDED                                 | -->
<!-- =================================================================================== -->
<robot name="capstone_amr">
  <!--
    Isaac Sim source description.
    Coordinate convention: +X forward, +Y left, +Z up.
    base_link is the midpoint of the left/right drive-wheel axle.
    Mesh files use millimetres; mesh scale converts millimetres to metres.
    Geometry revision: AMR_MASTER_Linear v80.step (2026-10-16): aluminium
    profile frame with upper structure, Z10T mast, linear-guide drive-wheel
    suspension (modelled rigid) and 529 mm drive track. The base_link inertia
    box approximation from v28 is retained.
    v119 (2026-10-20) adds the four-piece housing, an Orbbec Gemini 2 depth
    camera in the housing nose (pitched 12 deg up) and the rear XT90 connector.

    Direct Isaac Sim import uses the expanded capstone_amr.urdf beside this file.
    Import as Robot Type=Wheeled, Base Type=Mobile, with self-collision disabled.
  -->
  <material name="aluminium">
    <color rgba="0.55 0.60 0.66 1"/>
  </material>
  <material name="dark_metal">
    <color rgba="0.28 0.33 0.39 1"/>
  </material>
  <material name="z10t_body">
    <color rgba="0.12 0.13 0.15 1"/>
  </material>
  <material name="housing">
    <color rgba="0.82 0.83 0.84 1"/>
  </material>
  <material name="rubber">
    <color rgba="0.04 0.045 0.055 1"/>
  </material>
  <link name="base_footprint"/>
  <link name="base_link">
    <inertial>
      <origin rpy="0 0 0" xyz="0 0 -0.0115"/>
      <mass value="12.8"/>
      <inertia ixx="0.29613333333333336" ixy="0" ixz="0" iyy="0.44461333333333336" iyz="0" izz="0.7253333333333334"/>
    </inertial>
    <!-- These four STLs are already expressed in the base_link CAD frame.
         chassis.stl also carries the rear XT90 connector. -->
    <visual>
      <origin rpy="0 0 0" xyz="0 0 0"/>
      <geometry>
        <mesh filename="../meshes/visual/chassis.stl" scale="0.001 0.001 0.001"/>
      </geometry>
      <material name="aluminium"/>
    </visual>
    <!-- Linear-guide suspension brackets of both drive wheels; rigid in this model. -->
    <visual>
      <origin rpy="0 0 0" xyz="0 0 0"/>
      <geometry>
        <mesh filename="../meshes/visual/drive_suspension.stl" scale="0.001 0.001 0.001"/>
      </geometry>
      <material name="dark_metal"/>
    </visual>
    <visual>
      <origin rpy="0 0 0" xyz="0 0 0"/>
      <geometry>
        <mesh filename="../meshes/visual/z10t.stl" scale="0.001 0.001 0.001"/>
      </geometry>
      <material name="z10t_body"/>
    </visual>
    <visual>
      <origin rpy="0 0 0" xyz="0 0 0"/>
      <geometry>
        <mesh filename="../meshes/visual/housing.stl" scale="0.001 0.001 0.001"/>
      </geometry>
      <material name="housing"/>
    </visual>
    <!-- Camera geometry is lumped into base_link like the LiDAR;
         gemini2.stl is expressed in the camera_link frame. -->
    <visual>
      <origin rpy="0 -0.20943951023931953 0" xyz="0.320488 0.025 0.061017"/>
      <geometry>
        <mesh filename="../meshes/visual/gemini2.stl" scale="0.001 0.001 0.001"/>
      </geometry>
      <material name="z10t_body"/>
    </visual>
    <!-- LiDAR geometry is lumped into base_link together with its mass. -->
    <visual>
      <origin rpy="0 0 0" xyz="0 0 -0.029"/>
      <geometry>
        <mesh filename="../meshes/visual/lidar_mount.stl" scale="0.001 0.001 0.001"/>
      </geometry>
      <material name="aluminium"/>
    </visual>
    <visual>
      <origin rpy="0 0 0" xyz="0 0 0.10860500000000001"/>
      <geometry>
        <mesh filename="../meshes/visual/lidar_body.stl" scale="0.001 0.001 0.001"/>
      </geometry>
      <material name="dark_metal"/>
    </visual>
    <!-- PhysX-friendly collision boxes from the v119 part bounds. The housing
         box also covers the lower frame, the suspension brackets, the camera
         (front at X 324 mm) and the XT90 connector (rear at X -326 mm). -->
    <collision>
      <origin rpy="0 0 0" xyz="0 0 0.0125"/>
      <geometry>
        <box size="0.656 0.556 0.135"/>
      </geometry>
    </collision>
    <collision>
      <origin rpy="0 0 0" xyz="0 0.229 0.09"/>
      <geometry>
        <box size="0.228 0.098 0.02"/>
      </geometry>
    </collision>
    <collision>
      <origin rpy="0 0 0" xyz="0 -0.229 0.09"/>
      <geometry>
        <box size="0.228 0.098 0.02"/>
      </geometry>
    </collision>
    <collision>
      <origin rpy="0 0 0" xyz="0.27 0.1326 0.066"/>
      <geometry>
        <box size="0.02 0.04 0.2"/>
      </geometry>
    </collision>
    <collision>
      <origin rpy="0 0 0" xyz="0.27 -0.1326 0.066"/>
      <geometry>
        <box size="0.02 0.04 0.2"/>
      </geometry>
    </collision>
    <collision>
      <origin rpy="0 0 0" xyz="-0.26 0.1326 0.066"/>
      <geometry>
        <box size="0.02 0.04 0.2"/>
      </geometry>
    </collision>
    <collision>
      <origin rpy="0 0 0" xyz="-0.26 -0.1326 0.066"/>
      <geometry>
        <box size="0.02 0.04 0.2"/>
      </geometry>
    </collision>
    <collision>
      <origin rpy="0 0 0" xyz="0.005 0.1326 0.156"/>
      <geometry>
        <box size="0.51 0.04 0.02"/>
      </geometry>
    </collision>
    <collision>
      <origin rpy="0 0 0" xyz="0.005 -0.1326 0.156"/>
      <geometry>
        <box size="0.51 0.04 0.02"/>
      </geometry>
    </collision>
    <collision>
      <origin rpy="0 0 0" xyz="0.24 0 0.176"/>
      <geometry>
        <box size="0.04 0.3107 0.02"/>
      </geometry>
    </collision>
    <collision>
      <origin rpy="0 0 0" xyz="0.25 0 0.421"/>
      <geometry>
        <box size="0.02 0.04 0.47"/>
      </geometry>
    </collision>
    <collision>
      <origin rpy="0 0 0" xyz="0.2372 0 0.6035"/>
      <geometry>
        <box size="0.0764 0.1 0.055"/>
      </geometry>
    </collision>
    <collision>
      <origin rpy="0 0 0" xyz="0.2308 0 0.6925"/>
      <geometry>
        <box size="0.123 0.233 0.123"/>
      </geometry>
    </collision>
    <!-- v3 mount: two extended walls, two upper side walls, and top plate.
         Small counterbored screw holes are omitted from collision geometry. -->
    <collision>
      <origin rpy="0 0 0" xyz="0 -0.035 0.0185"/>
      <geometry>
        <box size="0.080 0.010 0.105"/>
      </geometry>
    </collision>
    <collision>
      <origin rpy="0 0 0" xyz="0 0.035 0.0185"/>
      <geometry>
        <box size="0.080 0.010 0.105"/>
      </geometry>
    </collision>
    <collision>
      <origin rpy="0 0 0" xyz="-0.035 0 0.046"/>
      <geometry>
        <box size="0.010 0.060 0.050"/>
      </geometry>
    </collision>
    <collision>
      <origin rpy="0 0 0" xyz="0.035 0 0.046"/>
      <geometry>
        <box size="0.010 0.060 0.050"/>
      </geometry>
    </collision>
    <collision>
      <origin rpy="0 0 0" xyz="0 0 0.076"/>
      <geometry>
        <box size="0.080 0.080 0.010"/>
      </geometry>
    </collision>
    <collision>
      <origin rpy="0 0 0" xyz="0 0 0.10026"/>
      <geometry>
        <cylinder length="0.038884" radius="0.0385"/>
      </geometry>
    </collision>
  </link>
  <joint name="base_footprint_joint" type="fixed">
    <parent link="base_footprint"/>
    <child link="base_link"/>
    <origin rpy="0 0 0" xyz="0 0 0.086"/>
  </joint>
  <link name="left_drive_wheel_link">
    <inertial>
      <origin rpy="0 0 0" xyz="0 0 0"/>
      <mass value="2.2"/>
      <inertia ixx="0.004432479333333334" ixy="0" ixz="0" iyy="0.0081356" iyz="0" izz="0.004432479333333334"/>
    </inertial>
    <visual>
      <origin rpy="0 0 0" xyz="0 -0.029118494 0"/>
      <geometry>
        <mesh filename="../meshes/visual/nurirobot_wa171_3d_v5.stl" scale="0.001004086 0.001004086 0.001004086"/>
      </geometry>
      <material name="rubber"/>
    </visual>
    <collision>
      <origin rpy="1.57079632679 0 0" xyz="0 0 0"/>
      <geometry>
        <cylinder length="0.0446" radius="0.086"/>
      </geometry>
    </collision>
  </link>
  <joint name="left_drive_wheel_joint" type="continuous">
    <parent link="base_link"/>
    <child link="left_drive_wheel_link"/>
    <origin rpy="0 0 0" xyz="0.0 0.2645 0"/>
    <axis xyz="0 1 0"/>
    <dynamics damping="0.1" friction="0.05"/>
  </joint>
  <link name="right_drive_wheel_link">
    <inertial>
      <origin rpy="0 0 0" xyz="0 0 0"/>
      <mass value="2.2"/>
      <inertia ixx="0.004432479333333334" ixy="0" ixz="0" iyy="0.0081356" iyz="0" izz="0.004432479333333334"/>
    </inertial>
    <visual>
      <origin rpy="3.14159265359 0 0" xyz="0 0.029118494 0"/>
      <geometry>
        <mesh filename="../meshes/visual/nurirobot_wa171_3d_v5.stl" scale="0.001004086 0.001004086 0.001004086"/>
      </geometry>
      <material name="rubber"/>
    </visual>
    <collision>
      <origin rpy="1.57079632679 0 0" xyz="0 0 0"/>
      <geometry>
        <cylinder length="0.0446" radius="0.086"/>
      </geometry>
    </collision>
  </link>
  <joint name="right_drive_wheel_joint" type="continuous">
    <parent link="base_link"/>
    <child link="right_drive_wheel_link"/>
    <origin rpy="0 0 0" xyz="0.0 -0.2645 0"/>
    <axis xyz="0 1 0"/>
    <dynamics damping="0.1" friction="0.05"/>
  </joint>
  <link name="front_left_caster_mount_link">
    <inertial>
      <origin rpy="0 0 0" xyz="0 0 -0.00095"/>
      <mass value="0.05"/>
      <inertia ixx="9.015041666666666e-06" ixy="0" ixz="0" iyy="1.7265041666666667e-05" iyz="0" izz="2.5883333333333333e-05"/>
    </inertial>
    <visual>
      <origin rpy="0 0 0" xyz="0 0 0.0025"/>
      <geometry>
        <mesh filename="../meshes/visual/caster_mount_fixed.stl" scale="0.001 0.001 0.001"/>
      </geometry>
      <material name="aluminium"/>
    </visual>
    <collision>
      <origin rpy="0 0 0" xyz="0 0 -0.00095"/>
      <geometry>
        <box size="0.064 0.046 0.0069"/>
      </geometry>
    </collision>
  </link>
  <joint name="front_left_caster_mount_joint" type="fixed">
    <parent link="base_link"/>
    <child link="front_left_caster_mount_link"/>
    <origin rpy="0 0 0" xyz="0.19 0.22 -0.0215"/>
  </joint>
  <link name="front_left_caster_swivel_link">
    <inertial>
      <origin rpy="0 0 0" xyz="0.003485 0 -0.025688"/>
      <mass value="0.1"/>
      <inertia ixx="2.3639298133333337e-05" ixy="0" ixz="0" iyy="3.433077280833334e-05" iyz="0" izz="2.7758141341666667e-05"/>
    </inertial>
    <visual>
      <origin rpy="0 0 0" xyz="0 0 0"/>
      <geometry>
        <mesh filename="../meshes/visual/caster_swivel_frame.stl" scale="0.001 0.001 0.001"/>
      </geometry>
      <material name="dark_metal"/>
    </visual>
  </link>
  <joint name="front_left_caster_swivel_joint" type="continuous">
    <parent link="front_left_caster_mount_link"/>
    <child link="front_left_caster_swivel_link"/>
    <origin rpy="0 0 3.14159265359" xyz="0 0 0"/>
    <axis xyz="0 0 1"/>
    <dynamics damping="0.08" friction="0.02"/>
  </joint>
  <link name="front_left_caster_wheel_link">
    <inertial>
      <origin rpy="0 0 0" xyz="0 0 0"/>
      <mass value="0.05"/>
      <inertia ixx="8.93229166666667e-06" ixy="0" ixz="0" iyy="1.265625e-05" iyz="0" izz="8.93229166666667e-06"/>
    </inertial>
    <visual>
      <origin rpy="0 0 0" xyz="-0.020 0 0.042"/>
      <geometry>
        <mesh filename="../meshes/visual/caster_wheel.stl" scale="0.001 0.001 0.001"/>
      </geometry>
      <material name="rubber"/>
    </visual>
    <collision>
      <origin rpy="1.57079632679 0 0" xyz="0 0 0"/>
      <geometry>
        <cylinder length="0.025" radius="0.0225"/>
      </geometry>
    </collision>
  </link>
  <joint name="front_left_caster_wheel_joint" type="continuous">
    <parent link="front_left_caster_swivel_link"/>
    <child link="front_left_caster_wheel_link"/>
    <origin rpy="0 0 0" xyz="0.020 0 -0.042"/>
    <axis xyz="0 1 0"/>
    <dynamics damping="0.02" friction="0.01"/>
  </joint>
  <link name="front_right_caster_mount_link">
    <inertial>
      <origin rpy="0 0 0" xyz="0 0 -0.00095"/>
      <mass value="0.05"/>
      <inertia ixx="9.015041666666666e-06" ixy="0" ixz="0" iyy="1.7265041666666667e-05" iyz="0" izz="2.5883333333333333e-05"/>
    </inertial>
    <visual>
      <origin rpy="0 0 0" xyz="0 0 0.0025"/>
      <geometry>
        <mesh filename="../meshes/visual/caster_mount_fixed.stl" scale="0.001 0.001 0.001"/>
      </geometry>
      <material name="aluminium"/>
    </visual>
    <collision>
      <origin rpy="0 0 0" xyz="0 0 -0.00095"/>
      <geometry>
        <box size="0.064 0.046 0.0069"/>
      </geometry>
    </collision>
  </link>
  <joint name="front_right_caster_mount_joint" type="fixed">
    <parent link="base_link"/>
    <child link="front_right_caster_mount_link"/>
    <origin rpy="0 0 0" xyz="0.19 -0.22 -0.0215"/>
  </joint>
  <link name="front_right_caster_swivel_link">
    <inertial>
      <origin rpy="0 0 0" xyz="0.003485 0 -0.025688"/>
      <mass value="0.1"/>
      <inertia ixx="2.3639298133333337e-05" ixy="0" ixz="0" iyy="3.433077280833334e-05" iyz="0" izz="2.7758141341666667e-05"/>
    </inertial>
    <visual>
      <origin rpy="0 0 0" xyz="0 0 0"/>
      <geometry>
        <mesh filename="../meshes/visual/caster_swivel_frame.stl" scale="0.001 0.001 0.001"/>
      </geometry>
      <material name="dark_metal"/>
    </visual>
  </link>
  <joint name="front_right_caster_swivel_joint" type="continuous">
    <parent link="front_right_caster_mount_link"/>
    <child link="front_right_caster_swivel_link"/>
    <origin rpy="0 0 3.14159265359" xyz="0 0 0"/>
    <axis xyz="0 0 1"/>
    <dynamics damping="0.08" friction="0.02"/>
  </joint>
  <link name="front_right_caster_wheel_link">
    <inertial>
      <origin rpy="0 0 0" xyz="0 0 0"/>
      <mass value="0.05"/>
      <inertia ixx="8.93229166666667e-06" ixy="0" ixz="0" iyy="1.265625e-05" iyz="0" izz="8.93229166666667e-06"/>
    </inertial>
    <visual>
      <origin rpy="0 0 0" xyz="-0.020 0 0.042"/>
      <geometry>
        <mesh filename="../meshes/visual/caster_wheel.stl" scale="0.001 0.001 0.001"/>
      </geometry>
      <material name="rubber"/>
    </visual>
    <collision>
      <origin rpy="1.57079632679 0 0" xyz="0 0 0"/>
      <geometry>
        <cylinder length="0.025" radius="0.0225"/>
      </geometry>
    </collision>
  </link>
  <joint name="front_right_caster_wheel_joint" type="continuous">
    <parent link="front_right_caster_swivel_link"/>
    <child link="front_right_caster_wheel_link"/>
    <origin rpy="0 0 0" xyz="0.020 0 -0.042"/>
    <axis xyz="0 1 0"/>
    <dynamics damping="0.02" friction="0.01"/>
  </joint>
  <link name="rear_left_caster_mount_link">
    <inertial>
      <origin rpy="0 0 0" xyz="0 0 -0.00095"/>
      <mass value="0.05"/>
      <inertia ixx="9.015041666666666e-06" ixy="0" ixz="0" iyy="1.7265041666666667e-05" iyz="0" izz="2.5883333333333333e-05"/>
    </inertial>
    <visual>
      <origin rpy="0 0 0" xyz="0 0 0.0025"/>
      <geometry>
        <mesh filename="../meshes/visual/caster_mount_fixed.stl" scale="0.001 0.001 0.001"/>
      </geometry>
      <material name="aluminium"/>
    </visual>
    <collision>
      <origin rpy="0 0 0" xyz="0 0 -0.00095"/>
      <geometry>
        <box size="0.064 0.046 0.0069"/>
      </geometry>
    </collision>
  </link>
  <joint name="rear_left_caster_mount_joint" type="fixed">
    <parent link="base_link"/>
    <child link="rear_left_caster_mount_link"/>
    <origin rpy="0 0 0" xyz="-0.19 0.22 -0.0215"/>
  </joint>
  <link name="rear_left_caster_swivel_link">
    <inertial>
      <origin rpy="0 0 0" xyz="0.003485 0 -0.025688"/>
      <mass value="0.1"/>
      <inertia ixx="2.3639298133333337e-05" ixy="0" ixz="0" iyy="3.433077280833334e-05" iyz="0" izz="2.7758141341666667e-05"/>
    </inertial>
    <visual>
      <origin rpy="0 0 0" xyz="0 0 0"/>
      <geometry>
        <mesh filename="../meshes/visual/caster_swivel_frame.stl" scale="0.001 0.001 0.001"/>
      </geometry>
      <material name="dark_metal"/>
    </visual>
  </link>
  <joint name="rear_left_caster_swivel_joint" type="continuous">
    <parent link="rear_left_caster_mount_link"/>
    <child link="rear_left_caster_swivel_link"/>
    <origin rpy="0 0 3.14159265359" xyz="0 0 0"/>
    <axis xyz="0 0 1"/>
    <dynamics damping="0.08" friction="0.02"/>
  </joint>
  <link name="rear_left_caster_wheel_link">
    <inertial>
      <origin rpy="0 0 0" xyz="0 0 0"/>
      <mass value="0.05"/>
      <inertia ixx="8.93229166666667e-06" ixy="0" ixz="0" iyy="1.265625e-05" iyz="0" izz="8.93229166666667e-06"/>
    </inertial>
    <visual>
      <origin rpy="0 0 0" xyz="-0.020 0 0.042"/>
      <geometry>
        <mesh filename="../meshes/visual/caster_wheel.stl" scale="0.001 0.001 0.001"/>
      </geometry>
      <material name="rubber"/>
    </visual>
    <collision>
      <origin rpy="1.57079632679 0 0" xyz="0 0 0"/>
      <geometry>
        <cylinder length="0.025" radius="0.0225"/>
      </geometry>
    </collision>
  </link>
  <joint name="rear_left_caster_wheel_joint" type="continuous">
    <parent link="rear_left_caster_swivel_link"/>
    <child link="rear_left_caster_wheel_link"/>
    <origin rpy="0 0 0" xyz="0.020 0 -0.042"/>
    <axis xyz="0 1 0"/>
    <dynamics damping="0.02" friction="0.01"/>
  </joint>
  <link name="rear_right_caster_mount_link">
    <inertial>
      <origin rpy="0 0 0" xyz="0 0 -0.00095"/>
      <mass value="0.05"/>
      <inertia ixx="9.015041666666666e-06" ixy="0" ixz="0" iyy="1.7265041666666667e-05" iyz="0" izz="2.5883333333333333e-05"/>
    </inertial>
    <visual>
      <origin rpy="0 0 0" xyz="0 0 0.0025"/>
      <geometry>
        <mesh filename="../meshes/visual/caster_mount_fixed.stl" scale="0.001 0.001 0.001"/>
      </geometry>
      <material name="aluminium"/>
    </visual>
    <collision>
      <origin rpy="0 0 0" xyz="0 0 -0.00095"/>
      <geometry>
        <box size="0.064 0.046 0.0069"/>
      </geometry>
    </collision>
  </link>
  <joint name="rear_right_caster_mount_joint" type="fixed">
    <parent link="base_link"/>
    <child link="rear_right_caster_mount_link"/>
    <origin rpy="0 0 0" xyz="-0.19 -0.22 -0.0215"/>
  </joint>
  <link name="rear_right_caster_swivel_link">
    <inertial>
      <origin rpy="0 0 0" xyz="0.003485 0 -0.025688"/>
      <mass value="0.1"/>
      <inertia ixx="2.3639298133333337e-05" ixy="0" ixz="0" iyy="3.433077280833334e-05" iyz="0" izz="2.7758141341666667e-05"/>
    </inertial>
    <visual>
      <origin rpy="0 0 0" xyz="0 0 0"/>
      <geometry>
        <mesh filename="../meshes/visual/caster_swivel_frame.stl" scale="0.001 0.001 0.001"/>
      </geometry>
      <material name="dark_metal"/>
    </visual>
  </link>
  <joint name="rear_right_caster_swivel_joint" type="continuous">
    <parent link="rear_right_caster_mount_link"/>
    <child link="rear_right_caster_swivel_link"/>
    <origin rpy="0 0 3.14159265359" xyz="0 0 0"/>
    <axis xyz="0 0 1"/>
    <dynamics damping="0.08" friction="0.02"/>
  </joint>
  <link name="rear_right_caster_wheel_link">
    <inertial>
      <origin rpy="0 0 0" xyz="0 0 0"/>
      <mass value="0.05"/>
      <inertia ixx="8.93229166666667e-06" ixy="0" ixz="0" iyy="1.265625e-05" iyz="0" izz="8.93229166666667e-06"/>
    </inertial>
    <visual>
      <origin rpy="0 0 0" xyz="-0.020 0 0.042"/>
      <geometry>
        <mesh filename="../meshes/visual/caster_wheel.stl" scale="0.001 0.001 0.001"/>
      </geometry>
      <material name="rubber"/>
    </visual>
    <collision>
      <origin rpy="1.57079632679 0 0" xyz="0 0 0"/>
      <geometry>
        <cylinder length="0.025" radius="0.0225"/>
      </geometry>
    </collision>
  </link>
  <joint name="rear_right_caster_wheel_joint" type="continuous">
    <parent link="rear_right_caster_swivel_link"/>
    <child link="rear_right_caster_wheel_link"/>
    <origin rpy="0 0 0" xyz="0.020 0 -0.042"/>
    <axis xyz="0 1 0"/>
    <dynamics damping="0.02" friction="0.01"/>
  </joint>
  <!--
    Fixed LiDAR assembly. The lidar_link origin is the CAD sensor origin and
    scan centre: base_link xyz = 0 0 0.108605 m, rpy = 0 0 0.
    Visuals, collisions and physical mass are lumped into base_link. These
    empty fixed links preserve the mounting and scan coordinate frames for
    an Isaac Sim RTX LiDAR prim.
  -->
  <link name="lidar_mount_link"/>
  <joint name="lidar_mount_joint" type="fixed">
    <parent link="base_link"/>
    <child link="lidar_mount_link"/>
    <origin rpy="0 0 0" xyz="0 0 -0.029"/>
  </joint>
  <link name="lidar_link"/>
  <joint name="lidar_joint" type="fixed">
    <parent link="lidar_mount_link"/>
    <child link="lidar_link"/>
    <origin rpy="0 0 0" xyz="0 0 0.137605"/>
  </joint>
  <!-- Real S2 scan axes: +X points backwards relative to the robot. -->
  <link name="laser"/>
  <joint name="laser_joint" type="fixed">
    <parent link="lidar_link"/>
    <child link="laser"/>
    <origin rpy="0 0 3.141592653589793" xyz="0 0 0"/>
  </joint>
  <!-- LSM6DSV16X chip centre measured in CAD (v119 board position, 2026-10-23);
       axes match base_link. The EKF fuses only gyro Z, so this offset does
       not change the fused yaw rate. -->
  <link name="imu_link"/>
  <joint name="imu_joint" type="fixed">
    <parent link="base_link"/>
    <child link="imu_link"/>
    <origin rpy="0 0 0" xyz="0.097 0 0.021"/>
  </joint>
  <!--
    Orbbec Gemini 2 mount frame (+X along the optical axis, +Z up, pitched
    11.25 deg up as measured; CAD 12 deg). OrbbecSDK_ROS2 publishes camera_link -> depth/color/IR and
    optical frames itself from the factory calibration, so none of those
    frames are defined here. Depth FOV 91 x 66 deg, 50 mm baseline.
  -->
  <link name="camera_link"/>
  <joint name="camera_joint" type="fixed">
    <parent link="base_link"/>
    <child link="camera_link"/>
    <origin rpy="0 -0.19634954084936207 0" xyz="0.320488 0.025 0.061017"/>
  </joint>
</robot>
