actaeon7777/multifloor-amr/src/amr_system/amr_stack/config/localization_startup.yaml

# AMCL uses 1080 beams during initialization, then returns to the tracking
# budget after verification. Only max_beams changes; its 30m range is unchanged.
# Independent verification uses up to 360 beams and shares AMCL's 30m range.
navigation_startup:
  ros__parameters:
    automatic_localization: true
    # TIM finds a laser pose from /map + /scan; the supervisor alone seeds AMCL.
    # Use 'amcl' explicitly only to compare the former uniform-particle search.
    global_localization_backend: tim
    tim_service: /localization/global_localize
    tim_timeout_sec: 30.0
    tim_max_candidates: 5
    # Only quiet drift inside these bounds is transported to the latest scan.
    # Every odometry sample must stay within the bounds throughout inference.
    tim_max_compensation_translation: 0.02
    tim_max_compensation_yaw: 0.01
    initialization_max_beams: 1080
    tracking_max_beams: 60
    global_frame: map
    odom_frame: odom
    base_frame: base_footprint
    data_timeout: 1.5
    pose_timeout: 3.0
    search_timeout: 60.0
    verification_duration: 2.5
    verification_samples: 6
    # A human supplies the global prior. Keep both beam-profile checks, but
    # require a shorter window with distinct AMCL poses as well as new scans.
    manual_verification_duration: 1.0
    manual_verification_samples: 4
    # Scan-match a manual/elevator prior within this window before AMCL
    # verifies it; a failed match keeps the given pose unchanged.
    manual_refinement: true
    refinement_position_window: 1.0
    refinement_yaw_window: 0.4363323129985824
    refinement_timeout: 5.0
    # Motion during a refinement re-runs it once the robot is still (the
    # elevator mission seeds its hall pose the instant the exit leg ends and
    # residual odometry discarded every refinement, 2026-10-26); at most this
    # many runs within refinement_timeout * refinement_attempts.
    refinement_attempts: 4
    # Last verified stopped pose per map, offered in the web UI as a prior the
    # operator confirms. Empty string disables saving.
    last_pose_file: ~/.ros/amr_last_pose.json
    # Refresh stationary AMCL faster only while localization is being verified.
    initialization_update_interval: 0.25
    tracking_update_interval: 1.0
    # After READY, initial confidence limits only report tracking_warning.
    # They must not undo initialization or cancel a running navigation goal.
    # Invalid/stale data, TF, malformed covariance, free-space and lifecycle
    # faults still close the gate. Their recovery requires new stopped evidence.
    tracking_verification_duration: 1.0
    tracking_verification_samples: 4
    # After READY, an AMCL pose vs map->odom gap up to these bounds is a warning
    # (AMCL future-stamps TF, so a correction briefly blends old and new);
    # beyond them the gate closes as before.
    tracking_tf_jump_xy: 1.0
    tracking_tf_jump_yaw: 0.5
    # Covariance limits for the tracking_warning after READY. The admission
    # limits (0.35 m / 0.25 rad) stay for initialization; a long corridor
    # legitimately reaches 0.36-0.39 m between distinctive features.
    tracking_max_xy_std: 0.6
    tracking_max_yaw_std: 0.35
    # Match-ratio limit for the tracking_warning after READY. Objects missing
    # from the map (401 doorway) give 68-70 % at the correct pose, a cluttered
    # 4F corridor 59 % (2026-10-26).
    tracking_min_match_ratio: 0.50
    max_xy_std: 0.35
    max_yaw_std: 0.25
    min_particle_concentration: 0.90
    # TIM candidates, the automatic search and a refinement that moves an
    # operator pose.
    min_match_ratio: 0.70
    # Operator poses (map click, "마지막 위치 적용"), lowered for the same
    # clutter as above (2026-10-27).
    manual_min_match_ratio: 0.50
    # The first /initialpose after an elevator resume (the mission's hall pose)
    # carries a tight prior: beacon-confirmed floor, in-car wall alignment and
    # a straight exit leg. No corridor-copy ambiguity applies, so admit it
    # here and let AMCL correct on the straight corridor leg that follows.
    after_ride_min_match_ratio: 0.50
    min_known_ratio: 0.85
    min_valid_beams: 30
    quality_max_beams: 360
    quality_max_range: 30.0
    tracking_quality_max_range: 30.0
    match_tolerance: 0.20
    ambiguity_margin: 0.10
    rival_position_step: 0.5
    rival_yaw_step: 0.2617993877991494
    rival_max_candidates: 200000
    service_timeout: 5.0
    navigation_start_timeout: 90.0
    stationary_linear_speed: 0.02
    stationary_angular_speed: 0.04
    stationary_duration: 1.0
