actaeon7777/multifloor-amr/sim/reference/wa172e_actuator_parameters.yaml

model: NURIROBOT WA172E
sources:
  datasheet: user_supplied_datasheet
  odrive_configuration: user_supplied_screenshots_in_WA172E_Motor_setting

datasheet:
  motor_type: sensored_3_phase_bldc
  nominal_voltage_v: 24.0
  nominal_output_power_w: 60.0
  nominal_torque_nm: 5.0
  nominal_speed_rpm: 115.0
  nominal_current_a: 5.0
  stall_torque_nm: 13.0
  stall_current_a: 13.0
  no_load_speed_rpm: 210.0
  no_load_current_a: 0.8
  number_of_poles: 30
  phase_to_phase_resistance_ohm: 1.37
  torque_constant_nm_per_a: 1.0
  speed_constant_rpm_per_v: 8.75
  mass_kg: 2.2
  wheel_diameter_m: 0.172
  wheel_width_m: 0.0446
  encoder_pulses_per_revolution: 800
  encoder_counts_per_revolution: 3200

odrive:
  supply:
    dc_bus_overvoltage_trip_v: 31.0
    dc_bus_undervoltage_trip_v: 23.0
    dc_max_positive_current_a: 6.0
    dc_max_negative_current_a: -5.0
    brake_resistor_ohm: 2.0
  motor:
    type: high_current
    pole_pairs: 15
    kv_rpm_per_v: 8.7
    displayed_torque_constant_nm_per_a: 0.951
    current_limit_a: 13.0
    displayed_current_limit_torque_nm: 12.357
    calibration_current_a: 3.333
    calibration_voltage_v: 4.0
    lockin_spin_current_a: 3.333
    current_control_bandwidth_hz: 100.0
    thermistor_r25_ohm: 20000.0
    thermistor_beta_k: 3950.0
    max_temperature_c: 130.0
  controller:
    control_mode: ramped_velocity
    ramp_limit_turn_s2: 2.0
    soft_velocity_limit_turn_s: 2.0
    hard_velocity_limit_turn_s: 3.0
    torque_limit_enabled: false
    velocity_gain_nm_per_turn_s: 3.0
    velocity_integrator_gain_nm_per_turn: 25.0
    position_gain_turn_s_per_turn: 20.0
  can:
    bitrate_bits_s: 500000
    encoder_estimates_period_ms: 10

derived:
  wheel_radius_m: 0.086
  odrive_no_load_speed_at_24v_rpm: 208.8
  odrive_no_load_speed_at_24v_rad_s: 21.865484869
  odrive_soft_velocity_limit_rad_s: 12.566370614
  odrive_hard_velocity_limit_rad_s: 18.849555922
  odrive_ramp_limit_rad_s2: 12.566370614
  odrive_velocity_gain_nm_per_rad_s: 0.477464829
  physics_drive_pi_surrogate_gain_nm_per_rad_s: 5.0
  soft_limit_linear_speed_m_s: 1.080707873
  hard_limit_linear_speed_m_s: 1.621061809
  soft_limit_in_place_angular_speed_rad_s: 4.331494480
  performance_velocity_dependent_resistance_nm_per_rad_s: 0.565137251
  performance_speed_effort_gradient_rad_s_per_nm: 1.769481660
  envelope_torque_at_datasheet_nominal_speed_nm: 5.551181034
  envelope_peak_mechanical_power_w: 67.547949132
  encoder_angle_resolution_rad: 0.001963495

simulation:
  max_force_nm: 12.357
  hard_joint_velocity_rad_s: 18.849555922
  max_actuator_velocity_rad_s: 21.865484869
  velocity_dependent_resistance_nm_per_rad_s: 0.565137251
  speed_effort_gradient_rad_s_per_nm: 1.769481660
  velocity_drive_damping_nm_per_rad_s: 5.0
  joint_friction: 0.02
  controller_max_linear_speed_m_s: 1.080707873
  controller_max_angular_speed_rad_s: 4.331494480
  controller_max_wheel_speed_rad_s: 12.566370614
  controller_max_linear_acceleration_m_s2: 0.8
  controller_max_linear_deceleration_m_s2: 0.8
  controller_max_angular_acceleration_rad_s2: 1.0
  combined_wheel_ramp_peak_rad_s2: 12.203488372
  usd_authored_hard_joint_velocity_deg_s: 1080.0
  usd_authored_max_actuator_velocity_deg_s: 1252.8
  usd_authored_speed_effort_gradient_deg_s_per_nm: 101.383831027
  usd_authored_velocity_dependent_resistance_nm_per_deg_s: 0.009863506
  usd_authored_velocity_drive_damping_nm_per_deg_s: 0.087266463

assumptions:
  - The screenshots apply to both left and right WA172E/ODrive axes.
  - The motor performance envelope uses 12.357 N m at zero speed and KV 8.7 rpm/V at the 24 V nominal bus as a conservative linear approximation.
  - The ODrive 2 turn/s soft limit is the normal command clamp; 3 turn/s is enforced separately as the PhysX hard joint-speed limit.
  - The 6 A DC bus input limit and regenerative current/brake resistor behavior are recorded but are not represented by the per-joint PhysX drive model.
  - ODrive velocity integrator gain is recorded but is not modeled because PhysicsDriveAPI provides a PD drive, not an integral controller state.
  - The 5 N m/(rad/s) effective Physics drive gain is a PI-response surrogate; the raw ODrive proportional term alone is 0.477464829 N m/(rad/s).
  - The chassis-space acceleration limits keep the worst simultaneous linear-plus-angular wheel ramp below the ODrive 2 turn/s^2 setting.
