actaeon7777/multifloor-amr/src/amr_system/amr_tim_localization/include/relocalization/utils/relocalization_2d/area_set_2d.h

/**
 * @author
 *   ZHANG Muhua
 * @affiliation
 *   Southwest Jiaotong University
 * @license
 *    GPL-3.0 License
 */

#ifndef AREA_SET_2D_H
#define AREA_SET_2D_H

#include <random>
#include <map>
#include <unordered_map>
#include <relocalization/utils/math_utils.h>
#include <relocalization/utils/relocalization_2d/sector_query_2d.h>
#include <relocalization/utils/relocalization_2d/sampling_2d.h>
#include <nav_msgs/msg/occupancy_grid.hpp>
#include <tf2_geometry_msgs/tf2_geometry_msgs.hpp>
#include <sensor_msgs/msg/laser_scan.hpp>
#include <geometry_msgs/msg/pose_with_covariance_stamped.hpp>
#include <geometry_msgs/msg/transform_stamped.hpp>
#include <sensor_msgs/msg/point_cloud2.hpp>
#include <atomic>

using namespace std;

namespace area_set_2d
{
    class area_set_2d
    {
    public:
        area_set_2d(const bool &use_traversability_sampling = false,
                    const float &rrt_min_expand_dist = 0.5, const float &rrt_max_expand_dist = 1.0, const int &traversability_sampling_duration = 5,
                    const int &map_free_threshold = 30, const int &map_occupied_threshold = 50,
                    const float &sensing_radius = 10.0f, const float &anchor_point_min_dist = 2.0f,
                    const float &angle_search_step = 0.174);
        ~area_set_2d() {};

        vector<tuple<geometry_msgs::msg::Point32, vector<float>>> get_area_set(
            const nav_msgs::msg::OccupancyGrid &map,
            const sensor_msgs::msg::LaserScan &scan,
            const bool &lidar_reverted,
            const int &lidar_sampling_step,
            const vector<float> &min_dist_to_obs_table,
            float &min_dist_to_obstacle,
            const bool &enable_visualization = false);

    private:
        bool use_traversability_sampling_;
        float rrt_min_expand_dist_, rrt_max_expand_dist_;
        int traversability_sampling_duration_;

        int map_free_threshold_;
        int map_occupied_threshold_;
        float sensing_radius_;
        float anchor_point_min_dist_;
        float angle_search_step_;


        nav_msgs::msg::OccupancyGrid get_area_submap(const nav_msgs::msg::OccupancyGrid &map,
                                                const sensor_msgs::msg::LaserScan &scan,
                                                const bool &lidar_reverted,
                                                const int &lidar_sampling_step,
                                                const geometry_msgs::msg::Point32 &anchor_point,
                                                const float &max_radius);

        vector<float> get_mean_dist_list(const nav_msgs::msg::OccupancyGrid &map,
                                         const sensor_msgs::msg::LaserScan &scan,
                                         const bool &lidar_reverted,
                                         const int &lidar_sampling_step,
                                         const geometry_msgs::msg::Point32 &anchor_point,
                                         const float &max_radius);
    };
}

#endif
