actaeon7777/multifloor-amr/src/amr_system/amr_tim_localization/include/relocalization/utils/relocalization_2d/rrt_common.h

/**
 * @author
 *   ZHANG Muhua
 * @affiliation
 *   Southwest Jiaotong University
 * @license
 *    GPL-3.0 License
 */

#ifndef RRT_COMMON_H
#define RRT_COMMON_H

#include <unordered_map>
#include <relocalization/utils/math_utils.h>
#include <geometry_msgs/msg/point.hpp>
#include <geometry_msgs/msg/point32.hpp>

using namespace std;

struct rrt_nodes
{
    vector<int> indices;
    vector<geometry_msgs::msg::Point32> points;
    vector<int> prev_indices;
    vector<geometry_msgs::msg::Point32> prev_points;
    vector<vector<int>> next_indices;
    vector<vector<geometry_msgs::msg::Point32>> next_points;
};

#endif
