actaeon7777/multifloor-amr/(commit log)

2026-10-15 Clean up workspace: drop transfer/merge leftovers, move misc files
    - Remove stub docs, ZIP transfer README/manifest, docs/archive, root maps/
    (copy of amr_stack/maps), verify_documentation.py and unused src/ scripts
    - Fold MERGE_NOTES engineering log into ELEVATOR_DESIGN/SIM2REAL appendices
    - README now carries the project overview (was PROJECT_OVERVIEW.md)
    - stm32_main_code.c -> firmware/stm32/main.c, can0.service -> deploy/jetson/,
    Elevator_size.jpg -> docs/images/, src/auto_turn_test.py -> scripts/
2026-10-15 Drop ZIP release tooling, legacy Isaac installers and regenerated reports
    - Jetson deploy now goes through git tags (SIM2REAL.md updated)
    - reports/*.json except source_snapshot.json are outputs; ignore them
    - UI/UX backlog CSVs moved to GitHub Issues #1-#24
2026-10-15 amr_remote_bridge: relay floor list and floor maps for cross-floor goals
    The central UI could not show floor tabs or other floors' maps because the
    agent only forwarded /api/state and the live layers. Now:
    - agent polls /api/floors at the layer cadence and uploads each floor's
    static map once as a 'floor/<floor>' layer (re-sent when the host asks)
    - Registry serves /api/floors (versions translated to host revisions) and
    /api/floors/<floor>/map.png on both the stdlib and FastAPI front-ends
    - a goal with floor/room on another floor is validated against that floor's
    map; the command carries map_layer so the agent checks the same image
    - layer scheduling picks the least recently tried laye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
2026-10-15 sim: match wheel (100 Hz) and LiDAR (10 Hz) rates to the real robot
    The 2026-10-04 alignment to bag 012425 was lost when the PC workspace was
    merged. Headless smoke test and an arena Nav2 trial pass at the new rates.
2026-10-16 rl: Isaac Lab local navigation policy and evaluation tools
    AMR-Nav-Arena-v0 trains a PPO policy to replace DWB inside Nav2: LiDAR,
    global path and goal pose in, (v, w) out through the robot's command path.
    - Path field follows Smac 2D on the global costmap (0.44 m inscribed
    radius, cost_travel_multiplier 4), so episodes no longer route through
    gaps the robot does not fit; the band inside the inscribed radius slopes
    back out without reopening those gaps.
    - Action std is bounded (0.05-0.8) after it grew to 4.6 in the first run.
    - evaluate/analyze_collisions run the deterministic policy, classify
    collisions and can put a RotationShimController model (amr_rl/shim.py,
    navigation.yaml v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
2026-10-16 description: v80 robot model (0.529 m track, 0.574 m footprint)
    URDF/Xacro and meshes from AMR_MASTER_Linear v80 (see
    src/amr_description/reports/UPDATE_V80.md): drive wheels 15 mm further
    out, profile frame with 2020 uprights and mast, Z10T body, linear-guide
    drive mounts; mounting plate removed. The STEP stays out of git (hash in
    input_sha256.json; *.step ignored).
    The 0.529 m track is applied to the STM32 default, control_mux, CAN
    telemetry, simulation physics and their tests; the local costmap footprint
    half-width becomes 0.287 m.
2026-10-16 stack: scan_body_filter drops returns from the robot's own uprights
    The v80 frame's four 2020 uprights cross the S2 scan plane at about
    0.27-0.28 m (+-22-30 deg, +-149-157 deg). The driver now publishes
    /scan_raw; scan_body_filter sets returns inside base_link boxes around the
    uprights (+0.03 m, inside the Nav2 footprint) to NaN and publishes /scan
    once the laser TF is known. record_trial.sh records both topics.
2026-10-16 nav2: rotation shim aligns once per goal, open loop
    rotate_to_heading_once: true. The behavior tree refreshes the path every
    10 s; each refresh re-armed the shim, which near the goal turns toward the
    goal point and fought DWB's final alignment (Isaac full-stack trial with
    the goal behind the robot: 1 of 3 timed out spinning at the goal).
    closed_loop: false. Closed loop limits the command to the measured rate +
    0.04 rad/s; in-place rotation measured ~85 % of the command in simulation,
    so the command stalled near 0.26 rad/s instead of 0.40.
    Simulation only (uncalibrated model); verify on the vehicle before merging.
2026-10-20 description: v119 model with housing, Gemini 2 camera and 18 kg mass
    URDF/Xacro and meshes from AMR_MASTER_Linear v119 (see
    src/amr_description/reports/UPDATE_V119.md): four-piece housing
    (X +-328, Y +-278 mm, fenders to Z 100 mm), Orbbec Gemini 2 in the
    housing nose pitched 12 deg up, rear XT90 connector. camera_link sits on
    the left IR lens axis; OrbbecSDK_ROS2 publishes the frames below it. The
    housing and fender boxes replace the lower-frame and suspension colliders.
    The STEP stays out of git (hash in input_sha256.json).
    The housing makes the body 0.656 m long: the local costmap footprint and
    the RL scan footprint become X +-0.328 m. Total mass is set to 18.0 kg,
    the 3.0 kg increase on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
2026-10-23 Real vehicle: LB takeover, STM32 E-stop interlock and elevator RF 1.1
    Joystick: AUTO is the default whether or not a controller is connected;
    the RB toggle is gone. LB pressed switches to MANUAL at once, stops
    autonomy and cancels the goal (OVERRIDDEN, mission MANUAL_OVERRIDE);
    AUTO returns 0.5 s after the last LB sample and nothing resumes.
    E-stop (docs/ESTOP_CAN_PROTOCOL.md v1.1): cmd_vel_to_can decodes the
    STM32 0x202 status and latches UNKNOWN/ESTOP/DISARMED. No 0x201 is sent
    until /estop/approve_resume (local web UI, pressed twice, or holding the
    joystick Menu button for 2 s), then (0, 0) until the drive gate opens.
    Missing status for 0.5 s, a trip_count change or a sequence jump is an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
2026-10-23 Floors: surveyed 3F/5F maps aligned to the 4F frame, floor monitor on the real vehicle
    3F and 5F now use the 2026-10-06 SLAM maps transformed into the 4F map
    frame (scripts/align_floor_map.py; 3F yaw 172.7 deg, 66 % of walls within
    0.15 m of 4F, elevator door within 6.5 cm). The 4F copies and
    provisional_copy_of are gone; real_enabled stays false until the elevator
    real-vehicle test. Sim scenes, zone images and room coordinates are still
    4F copies (MAP_SOURCE.md in each folder). experiment.sh real starts the
    floor monitor and mission manager by default so the web UI shows floor
    tabs and rooms; elevator:=false turns them off. Spawn moved 0.55 m to
    clear a hall object in the surveyed map.
    Co-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
2026-10-23 Localization and CPU: manual-pose scan matching, upright shadow filter, EventsExecutor
    Real-vehicle driving on 2026-10-23 stalled in place and lost goals. Three
    causes were found from the live topics and fixed:
    - A web initial pose was 0.3 m / 15 deg off and AMCL settled there (match
    69 %, warnings every second). navigation_startup now scan-matches a manual
    or elevator prior within +-1 m / +-25 deg before AMCL verifies it
    (refine_pose; 7.8 % -> 74.7 % and 45 % -> 81 % on the vehicle, READY in
    9 s). The last READY pose is saved per map (~/.ros/amr_last_pose.json)
    and offered in the web UI as "이전 위치로 시작", applied only after the
    operator confirms it. The web UI sent t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
2026-10-23 can_telemetry receive thread; tracking covariance limits for the warning
    can_telemetry woke the rclpy executor 200 times a second with a 5 ms poll
    timer for about 60 frames; a thread now blocks in SocketCAN recv and the
    executor only serves the 1 Hz diagnostics. Measured on the vehicle:
    30-42 % -> 12.9 % of a core, odometry 95 Hz / IMU 9.4 Hz with 5 ms / 1 ms
    median latency, unchanged message content.
    After READY the covariance diagnostic uses tracking_max_xy_std 0.6 m and
    tracking_max_yaw_std 0.35 rad instead of the admission limits: along a
    long corridor AMCL legitimately carries 0.36-0.39 m of longitudinal
    uncertainty, which produced 44-102 warnings per drive. A 401 -> 406 -> 401
    drive a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
2026-10-23 Tracking match-ratio limit for the warning; load-proof drift test; AMCL test cleanup
    After READY the scan-alignment diagnostic compares against
    tracking_min_match_ratio (0.60) instead of the 0.70 admission limit:
    objects missing from the map (furniture, open doors by the 401 doorway)
    gave 68-70 % at the correct pose and 41 warnings in one drive. The same
    401 -> 406 -> 401 drive afterwards: 2 momentary warnings at 59.4-59.7 %,
    0 readiness drops, both goals reached.
    test_manual_verification_bounds_gradual_drift_from_a_fixed_anchor spun a
    fixed 0.16 s per 10 cm step; on a loaded Jetson the supervisor skipped
    steps and judged only stale, mutually consistent observations, so the
    window completed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
2026-10-24 Elevator: real-vehicle hall call to in-car alignment; 3F enabled
    Two real-vehicle runs (4F 401 -> 3F 301/302) passed hall wait, HALL_CALL
    4F DOWN (PRESSED + BUTTON_ACK in 0.9-1.0 s, button lamp lit), door open,
    boarding and in-car alignment, then stopped safely on NO_CAR_ACK because
    the car beacon is not installed yet.
    - experiment.launch.py passes start_elevator_link / elevator_link_dry_run
    to bringup (default off / dry run), as used in the test.
    - floors.yaml: 3F real_enabled stays true. Without a car beacon a 3F goal
    ends in a safe stop inside the car and is recovered with LB.
    - Tests use 5F as the floor that is still disabled on the real vehicle.
    - Docs: test record, RF protocol sta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
2026-10-24 description: v130 camera and IMU placement check
    AMR_MASTER_Linear v130.step keeps the Gemini 2 at the v119 pose, so
    camera_link is unchanged. Factory extrinsics confirm the depth frame is
    the left (+Y) IR camera, and a floor-plane fit on the real vehicle gives
    11.84 deg pitch and 0.1476 m lens height (URDF 12 deg, 0.147 m). The
    camera's internal IMU is about 1.5 deg off its optical axes. Records the
    STEP hash; the STEP stays outside the workspace.
2026-10-24 web_ui: floor transit view (mission steps, door, button command, beacons)
    A third view next to the main map and vehicle status: the 11 floor-mission
    steps with timings, the current button command (sent -> RF delivered ->
    pressed, retries and late ACKs), the LiDAR door ratio, an event log and a
    card per beacon with strength and a 60 s reception timeline. Read-only;
    control nodes are unchanged. The remote relay serves transit.js too.
    Real vehicle (stationary, elevator link live): the 4F hall beacon card
    updates at ~1 Hz (51/60 s received, weak grade, 3.32 V), the uninstalled
    beacons show no reception, web_ui ~13 % CPU.
2026-10-24 Elevator link dry run also disables beacon reception
    elevator_can_link opens no CAN socket in dry run, so 0x310/0x311 beacon
    frames are not received either. Correct the launch argument description
    and the elevator doc: use elevator_link_dry_run:=false to see beacons.
2026-10-24 WIP backup: depth camera integration and no-resume-approval work
    Backup before fixing recovery clearing of depth obstacles; not yet
    validated on the real vehicle.
    - Gemini 2 depth camera: camera.launch.py, depth_layer in local and
    global costmaps, measured optical pitch 11.25 deg in URDF
    - amr_depth_filter: drops depth obstacle points that do not persist
    for 3 frames (glossy-floor outliers); Release build by default
    - Global costmap inflation_radius 1.6 -> 1.0 for straighter plans
    - E-stop resume approval removal, elevator, web UI and remote bridge
    changes from the no-resume-approval branch
2026-10-25 WIP backup: recovery keeps obstacles within 2 m of the robot
    Not yet validated on the real vehicle.
    - behavior_trees/navigate_to_pose_keep_nearby.xml: Nav2 consistent-
    replanning tree with every ClearEntireCostmap replaced by
    ClearCostmapExceptRegion(reset_distance 2.0), so a low obstacle in the
    depth camera's blind zone (2026-10-25 slipper) is not forgotten
    - navigation.launch.py uses it; setup.py installs behavior_trees/
    - test_depth_costmap_ros: near obstacle survives clear-except-region,
    far one is cleared; clear-entirely forgets the near one
2026-10-25 build: default C++ packages to Release
    sllidar_ros2 and amr_nav2_plugins compiled without a build type (-O0);
    the S2 SDK unpacks 32k samples/s and sorts ~3200 nodes per scan.
    build_ros.sh and the validation build line pass Release explicitly.
2026-10-25 navigation_startup: vectorise READY evidence and drop per-tick duplicates
    tracking_ray_poses interpolates all rays as arrays (4.45 -> 0.07 ms) and
    MapQuality.score builds only the active line-of-sight samples (2.85 ->
    1.01 ms, identical results on 584 real scans). Covariance checks and TF
    availability are cached within a tick, scan ranges are passed as a
    read-only array, odom history is 150 samples and status is published
    once per tick. Real vehicle: 24.1 -> 16.1 % of a core.
2026-10-25 scan_body_filter, navigation_manager: cache beam geometry, relay feedback at 10 Hz
    scan_body_filter caches beam cos/sin and shadow membership per scan
    layout and stops the /tf listener once the fixed laser pose is known
    (6.2 -> 1.8 %). navigation_manager relays bt_navigator feedback at
    10 Hz instead of every BT loop and keeps command messages without a
    deepcopy (16.7 -> 10.9 %).
2026-10-25 amr_elevator: numpy scan processing and quieter feedback
    Door detection, enclosure ratio, in-car points and travel clearance use
    numpy instead of 3240-beam Python loops; door measurement is skipped
    beyond max_view_distance (UNKNOWN is still published every scan).
    Clearance is computed once per scan, mission feedback is sent on change
    plus 1 Hz, the mission's /tf listener stops after the laser pose is
    known and elevator geometry is cached. Real vehicle: monitor 11.7 ->
    7.4 %, mission 11.5 -> 4.2 %.
2026-10-25 can_telemetry, time_health, joy: reuse messages, read stamps raw
    can_telemetry reuses its Odometry/JointState/Imu messages (identical
    bytes), checks the clock every 100 ms from the receive loop, publishes
    joint_states at 10 Hz and skips MotorStatus without subscribers.
    time_health reads scan/wheel/imu header stamps from raw CDR. The CAN
    preview line is skipped without subscribers (after the context check),
    joy_teleop spins an EventsExecutor and joy_autoselect polls at 4 Hz
    while no joystick is present. Real vehicle: can_telemetry 12.8 -> 9.7 %,
    time_health 12.0 -> 9.5 %, robot_state_publisher 3.5 -> 0.8 %.
2026-10-25 scripts: CPU profiling and bag-replay A/B tools; record round-1 results
    profile_nodes.py samples per-node CPU at 1 Hz during a drive;
    replay_cpu_ab.py and bench_map_quality_ab.py compare two code versions
    on a recorded bag. EXPERIMENTS.md records the baseline, the replay A/B
    and the real-vehicle re-measurement (Python nodes 135 -> 96 %).
2026-10-25 web_ui: on-robot delivery kiosk and operator set_floor
    Kiosk page at /kiosk for the Jetson touch screen (rooms, delivery progress,
    elevator steps, receipt confirmation, PIN-gated admin mode) with a light
    /api/kiosk/state, an X-AMR-Client: kiosk allow-list, PIN tokens from
    AMR_KIOSK_PIN, and /api/acknowledge. Stop cancels any active goal so it
    still works after the browser restarts mid-delivery.
    New set_floor command (operator page, kiosk admin, remote bridge) calls
    /floor/set_current when the robot is stopped and no floor mission runs.
    scripts/kiosk launches Chromium full screen; docs/KIOSK.md describes it.
2026-10-26 amr_stack: STVL depth layer replaces VoxelLayer in both costmaps
    On 2026-10-26 the robot stalled for 156 s on a 3.6 m leg after leaving the
    4F elevator and again in front of 401: depth marks beside the body that
    LiDAR could not explain kept every DWB trajectory illegal, and recovery
    (Spin: Collision Ahead, BackUp) could not clear them because the keep-nearby
    BT preserves 2 m around the robot. VoxelLayer only clears a mark when its
    own rays cross it, so marks that enter the camera's blind band (bumper to
    0.70 m ahead, the sides, behind) stayed forever; a removed object at 401
    stayed for the same reason.
    spatio_temporal_voxel_layer (ros-jazzy 2.5.5) expires a mark voxel_decay
    (10 s) after its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
2026-10-26 Elevator: 5F enabled, hall pose admitted at 50 %, door-open button off
    Floors: 5F real_enabled true on request (2026-10-27) before its first real
    ride; every mapped floor is now selectable, so the refusal tests disable
    5F in a test-local BuildingConfig. Room poses on 3F/5F remain the 4F
    values (all in free corridor, >= 0.55 m clearance) pending a site check.
    Localization after a ride: on 2026-10-26 RELOCALIZE stalled every time.
    The mission seeds the hall pose the instant its exit leg ends, residual
    odometry discarded the +-1 m scan-match refinement all three times, and
    the 0.37 m-off pose scored 40-69 % against the 70 % admission limit; the
    second exit needed a manual pose after 30 s. The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
2026-10-27 WIP backup: elevator people safety and CPU optimization round 2
    Not yet driven on the vehicle; pushed for Isaac Sim checks.
    Elevator (SPS-B-KOLA-0001-7700 robot-side items): in-car rotation and
    boarding/exit space checks from scan and depth (clearance.py), occupancy
    wait and cancel/back-out flows, Annex C announcements on
    robot/announcement, hall wait pose 1.0 m from the door on 3F-5F.
    CPU round 2: cmd_vel_to_can, can_telemetry and elevator_can_link on the
    EventsExecutor (100 ms timed wait so signals still stop them promptly);
    elevator_can_link receives on a blocking thread instead of a 10 ms poll.
    control_mux republishes only changed output, 20 Hz heartbeat kept.
    bt_navigator bt_loop_dura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
2026-10-27 docs: Isaac PC task for the global inflation obstacle-stall check
2026-10-27 Isaac check: global inflation vs obstacle stall (results only)
2026-10-27 navigation_startup: admit operator poses at a 50 % match ratio
    Cluttered corridors score 59-70 % at the correct pose, so a map click or
    "마지막 위치 적용" was rejected. TIM candidates, the automatic search and a
    refinement that moves an operator pose keep min_match_ratio 0.70.
2026-10-27 kiosk: same-floor delivery on an assumed startup floor
    A startup floor stays ASSUMED until the hall beacon is heard. Same-floor
    goals only need the loaded map, so they are allowed; other floors stay
    locked with a note until the floor is confirmed.
2026-10-27 Voice announcements on the display speaker
    announcement_player plays /robot/announcement keys as tools/tts/wav/<key>.wav
    through pw-play (HDMI) and loops drive.wav while the wheels move. The kiosk
    publishes delivery start/arrival/cancel/received/error, the player adds Nav2
    stall and E-stop cues, and the elevator mission announces an obstacle only
    after a 1.5 s hold. Launched by experiment.launch.py mode:=real
    (start_announcer, default true). WAVs come from tools/tts/generate_google_tts.py.
2026-10-27 Desktop launcher, run guide and CPU profiles
    scripts/launcher: "AMR 시작/종료" icons start the vehicle stack and web UI as
    user services and open the kiosk. 실행법.md documents the icon and terminal
    start-up. reports/profile holds the round-1/2 CPU profiles that
    docs/EXPERIMENTS.md and the 10-27 optimization audit cite.
2026-10-27 Operator hold: remote stop/resume, return home, task line
    /api/stop cancels the current goal and latches /operator/hold; navigation_manager
    finishes the request as HELD and refuses goals and new maneuver leases, the
    elevator mission cancels, and control_mux zeroes AUTO output (hold_grace 0)
    while LB manual driving stays available. The hold survives link loss and ends
    only with /api/resume. /api/return_home clears the hold and, once the old goal
    is terminal and the robot is ready, drives to floors.yaml home (4F 401) through
    the normal goal path with origin=return_home, which produces no delivery
    announcement or receipt screen. /api/state gains task and hold; the kiosk shows
    관리자 정지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
2026-10-27 Lightweight central console (protocol 2) with Slack arrival DM
    The agent sends a 16 KiB summary of /api/kiosk/state at 5 Hz and no images;
    the server keeps one card per robot (floor, x/y/yaw, task, battery, link age,
    hold) and relays only stop, resume and return_home. The full web UI, map and
    costmap layers, camera and goal relay are gone, and Control_Server runs the
    stdlib server directly (FastAPI/uvicorn removed; Python 3.10 suffices). The
    server sends a Slack DM to the room's recipient when a delivery it saw in
    progress reaches SUCCEEDED (never for return_home, never twice). The desktop
    launcher starts amr-agent.service when ~/.config/amr/agent.env exists.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
2026-10-27 Operator hold waits for the corridor during an elevator segment
    A stop requested between BOARDING and RELOCALIZE would leave the robot in the
    doorway or inside the car, where localisation is suspended and a remote return
    cannot start. The web UI now records such a stop as hold.pending, lets the
    mission continue, and publishes the hold once the mission reaches NAV_TO_GOAL
    or ends. Resume and return_home drop a pending hold. The console and kiosk show
    하차 후 정지 예정; hall phases and corridor goals still stop at once.
2026-10-27 Kiosk: close button, fullscreen watch, and an amr-kiosk user unit
    Admin mode gains 키오스크 닫기 (POST /api/kiosk/exit, loopback only, admin token
    when a PIN is set): the server SIGTERMs scripts/kiosk/launch.sh via its PID file,
    or closes an orphaned --class=amr-kiosk Chromium itself. launch.sh now watches
    _NET_WM_STATE for as long as the browser runs, because Chromium's own --kiosk
    fullscreen drops after ~0.1 s, replaces a launcher-less kiosk Chromium instead
    of handing it the URL, and finishes cleanup on a second TERM. The desktop icon
    starts the kiosk as the amr-kiosk unit through systemd-run: processes spawned
    from the desktop icon carry DING's AppArmor label and the Chromium snap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
2026-10-27 amr_patrol: fixed-route patrol on the current floor (4F_full)
    patrol_manager drives the waypoints of a route from amr_stack/config/patrol.yaml
    through navigation_manager's /navigate_to_pose, pauses dwell_s at observation
    stops (publishing /patrol/observation begin/end for the later detector), retries
    a failed waypoint once after retry_delay_s, skips it, and aborts after three
    consecutive failures or when another goal source preempts it. Hold, E-stop, a
    stop command, a floor change or an elevator zone abort the patrol without an
    automatic return; a sustained low battery returns home early. end: home drives
    to floors.yaml home (4F 401). /patrol/command (start/stop with request_id) and a
    retain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
2026-10-27 Patrol start/stop from the console and the kiosk admin mode
    web_ui: /api/patrol/start {route} and /api/patrol/stop (operator, or kiosk admin
    with the PIN token), state.patrol from /patrol/status with a 3 s freshness rule,
    task line 순찰 <route> i/n · 이동|관측|복귀, deliveries refused while a patrol is
    active, the kiosk shows 야간 순찰 중 and its admin mode gains a route select with
    순찰 시작/정지. Operator stop and return_home also stop a running patrol, and
    return_home waits until navigation is idle. Protocol 2 relays patrol_start and
    patrol_stop; the console card lists routes and shows progress, honouring the
    same freshness rule.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
2026-10-27 amr_patrol: motion detector (global costmap vs static map) with snapshots and an event spool
    motion_detector runs only while a patrol is active: it subscribes /map,
    /global_costmap/costmap(+updates), the camera JPEG and TF on start and drops
    them on end. Lethal costmap cells that the static map calls free (after a
    2-cell wall margin, outside exclusion rectangles and only where an update has
    refreshed the grid since activation) are clustered; a person-sized cluster
    whose centroid moved >= 0.35 m within 4 s, matched frame to frame with a
    speed-bounded radius, and whose origin cells are now vacated, is a detection.
    Range filtering is per cluster, turning frames are skipped, and repeats are
    supp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
2026-10-27 Console event feed: spooled robot events and snapshots stored on the server
    The agent uploads queued events (POST /api/agent/events, oldest first, 20 per
    cycle) and wanted images (POST /api/agent/images/<id>, one per cycle) with its
    own backoff so a failing upload never slows the state exchange; the JSON is
    deleted only after the server acknowledges it, missing images are logged and
    skipped, and permanently rejected files are quarantined. The server keeps an
    EventStore (SQLite + images/<robot>/<id>.jpg under Control_Server/data, pruned
    by count and bytes) and serves GET /api/events (after/limit/robot/kind_prefix)
    and the images to operators. The console shows a 감지 기록 feed ordered by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
2026-10-28 Elevator: split hall recess from threshold depth; weak target beacon after travel
    door_center on the map is the hall door panel, 0.37 m behind the corridor
    wall face. The sketch's 0.66 m was measured from the wall face, so the car
    was registered 0.33 m too deep (wall-fit correction kept returning
    -0.32..-0.345 m). floors.yaml now uses hall_recess_m 0.37 + threshold_depth_m
    0.32, and the door tunnel starts at the wall face so the recess side walls
    no longer block boarding from a slanted wait pose.
    A weak hall beacon from the target floor now confirms arrival when the door
    opens after at least min_travel_closed_s of closed-door travel.
    Also adds the 4F patrol route draft (reports/patrol) for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
2026-11-03 Elevator: drop RF/CAN beacon link; vision floor recognition and arrival confirm card
    Remove the elevator CAN/RF beacon link (elevator_can_link, protocol, RF status,
    ElevatorBeacon/Command/CommandStatus msgs). The robot no longer presses
    buttons; a person does. Floor arrival is judged by the new amr_floor_vision
    package (FloorVisionGuess) and confirmed through a kiosk/web arrival card
    (FloorArrivalConfirm, ElevatorRequest). Adds an elevator run recorder and
    analysis script, elevator tuning config, and camera settings helper.
    Real-vehicle test passed 2026-11-03.
2026-11-03 README: refresh for the current stack; ELEVATOR: vision floor passed the real-vehicle test
    README now covers the kiosk, patrol, vision floor recognition, depth camera
    and voice announcements, drops the removed RF relay, and states the
    2026-11-03 status. ELEVATOR.md marks the RF-free flow and the camera floor
    recognition as tested on the real vehicle.
